Pynckels/versalogic_board_tester/VersaLogic_Board_Tester.pdf

# Data620 Testing Device - Project Overview

The Data620 computer is a unique and fascinating machine built using analog electronic circuitry. It employs a versalogic signaling scheme where a logical false or bit value 0 is represented by 0V, while a logical true or bit value 1 is represented by -12V. This unconventional voltage scheme sets it apart from

many modern digital systems.

Constructed from basic electronic components such as resistors, capacitors,

## diodes, and transistors, the Data620’s entire system is divided into a large

number of printed circuit boards (PCBs). Each PCB contains analog circuitry,

## and it is known that some of these boards may include faulty or erroneous

components.

## Currently, there is no dedicated testing device available to verify the functionality of these PCBs. Such a device would be highly valuable to anyone restoring or working with the Data620, as it would allow for systematic troubleshooting and

repair.

This project represents the first draft towards developing such a testing device.

## It includes preliminary hardware design concepts and the necessary SPICE simulations to understand and verify the circuitry. However, at this stage, only

the hardware draft exists.

## Software development for this testing device is in its early stages and will proceed following the completion of a stable hardware version. It also awaits the reverse

engineering efforts of the DATA620 PCBs carried out by third parties.

This project is currently an independent effort (not affiliated with Usagi Electric or other existing Data620 projects). We hold great respect for the significant contributions and extensive work carried out by Usagi Electric and the dedicated volunteers contributing to the Usagi Electric Data620 project. Our development is separate, however, we are more than willing to explore opportunities to

collaborate and join forces in the future.

As this is an initial draft, the design undoubtedly contains errors and inaccuracies.

## We warmly welcome constructive feedback and suggestions from the community

to improve and refine the project.

## For those interested in learning more about the Data620 itself, the following discussion provides valuable insights and historical context:

## - https://retrocomputingforum.com/t/data-620-transistor-minicomputer/3847 - https://github.com/Nakazoto/Data620 - https://www.youtube.com/watch?v=YR9E9ZvHkQE

## Thank you to all that participate with Usagi Electric for your interest and

support in preserving this remarkable piece of computing history.

1

# License Overview

## Copyright (c) 2011-2025 Filip Pynckels & Robin Pynckels

## This project contains software, hardware designs, and documentation. Each part

is licensed under terms appropriate to its nature. You are free to use, modify, and distribute each component under its respective license terms.

# Hardware Designs

## The schematics, PCB layouts, and other hardware design source files are licensed under the CERN Open Hardware Licence Version 2 - Strongly

Reciprocal (CERN-OHL-S v2.0).

See CERN-OHL-S for the full text.

# Software

## The controller source code, build scripts, and related software files are licensed

under the MIT License.

See MIT for the full text.

# Documentation

## The written documentation, guides, and non-code instructional materials are licensed under the Creative Commons Attribution Non Commercial

Share Alike 4.0 International (CC-NC-SA 4.0) license.

See CC-NC-SA for the full text.

1

# Power Supply UART-RX UART-TX

# FLOATING-SH/~{LD} SIGNAL-OUT-SER

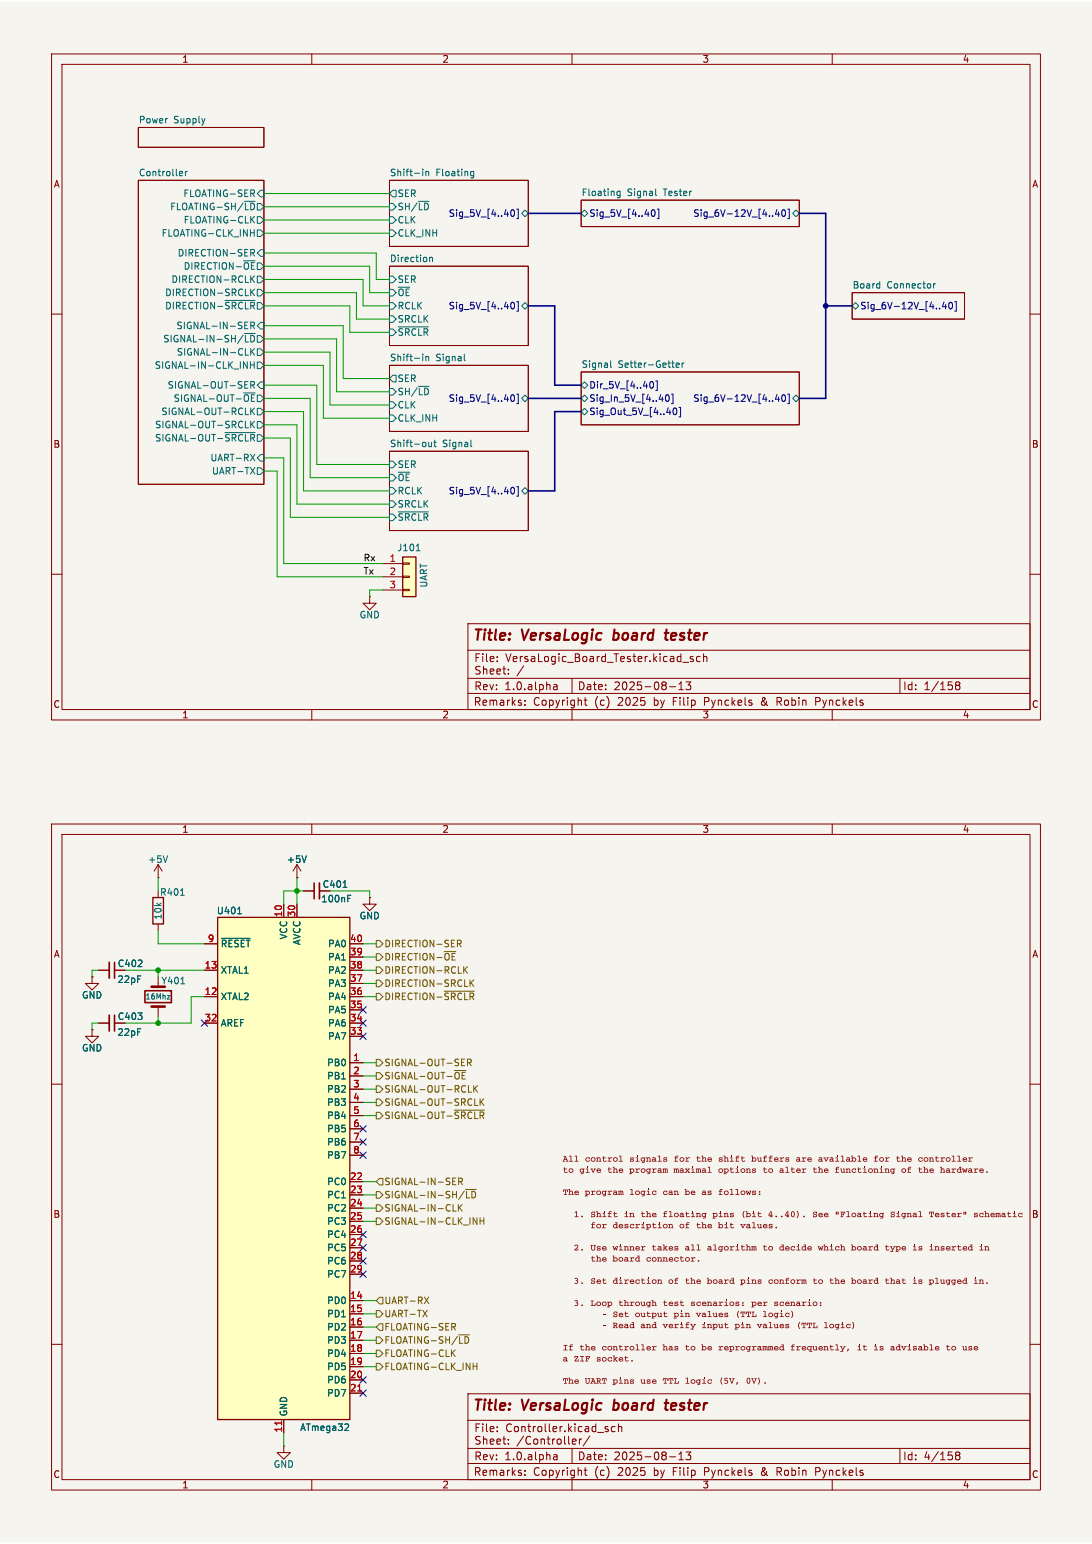
[picture p3: page 3]
BC Date: 2025-08-13 Remarks: Copyright; Filip; Pynckels &; Robin; Pynckels Rev: 1.0.alpha; Id: 1/158 Title: VersaLogic board tester File: VersaLogic_Board_Tester.kicad_sch Sheet: /; FLOATING-SER; DIRECTION-RCLK DIRECTION-~{OE} DIRECTION-SRCLK Controller; Sig_6V-12V_[4..40] Board Connector SER; CLK_INH; CLK; SH/~{LD} Sig_5V_[4..40] Shift-in; Floating; ~{SRCLR} RCLK; ~{OE} SRCLK; SER; Sig_5V_[4..40] Shift-out; Signal CLK_INH; Signal; Sig_5V_[4..40]; Sig_6V-12V_[4..40]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

Sig_5V_[4..40] Direction ~{SRCLR} RCLK

SIGNAL-IN-SH/~{LD} FLOATING-CLK
FLOATING-CLK_INH
SIGNAL-OUT-RCLK DIRECTION-~{SRCLR} DIRECTION-SER

SIGNAL-OUT-~{SRCLR} SIGNAL-IN-SER

SIGNAL-IN-CLK
SIGNAL-IN-CLK_INH

Signal Setter-Getter GND

SIGNAL-OUT-~{OE} SIGNAL-OUT-SRCLK

SIGNAL-IN-CLK DIRECTION-SER
DIRECTION-~{OE} SIGNAL-OUT-SER
SIGNAL-OUT-SRCLK DIRECTION-RCLK DIRECTION-~{SRCLR} FLOATING-CLK_INH
SIGNAL-OUT-~{SRCLR} UART-RX UART-TX

SIGNAL-OUT-~{OE}
SIGNAL-OUT-RCLK

SIGNAL-IN-SER
SIGNAL-IN-SH/~{LD}

FLOATING-SH/~{LD} SIGNAL-IN-CLK_INH

- Set output pin values (TTL logic)

a ZIF socket. The UART pins use TTL logic (5V, 0V).

LM393 +

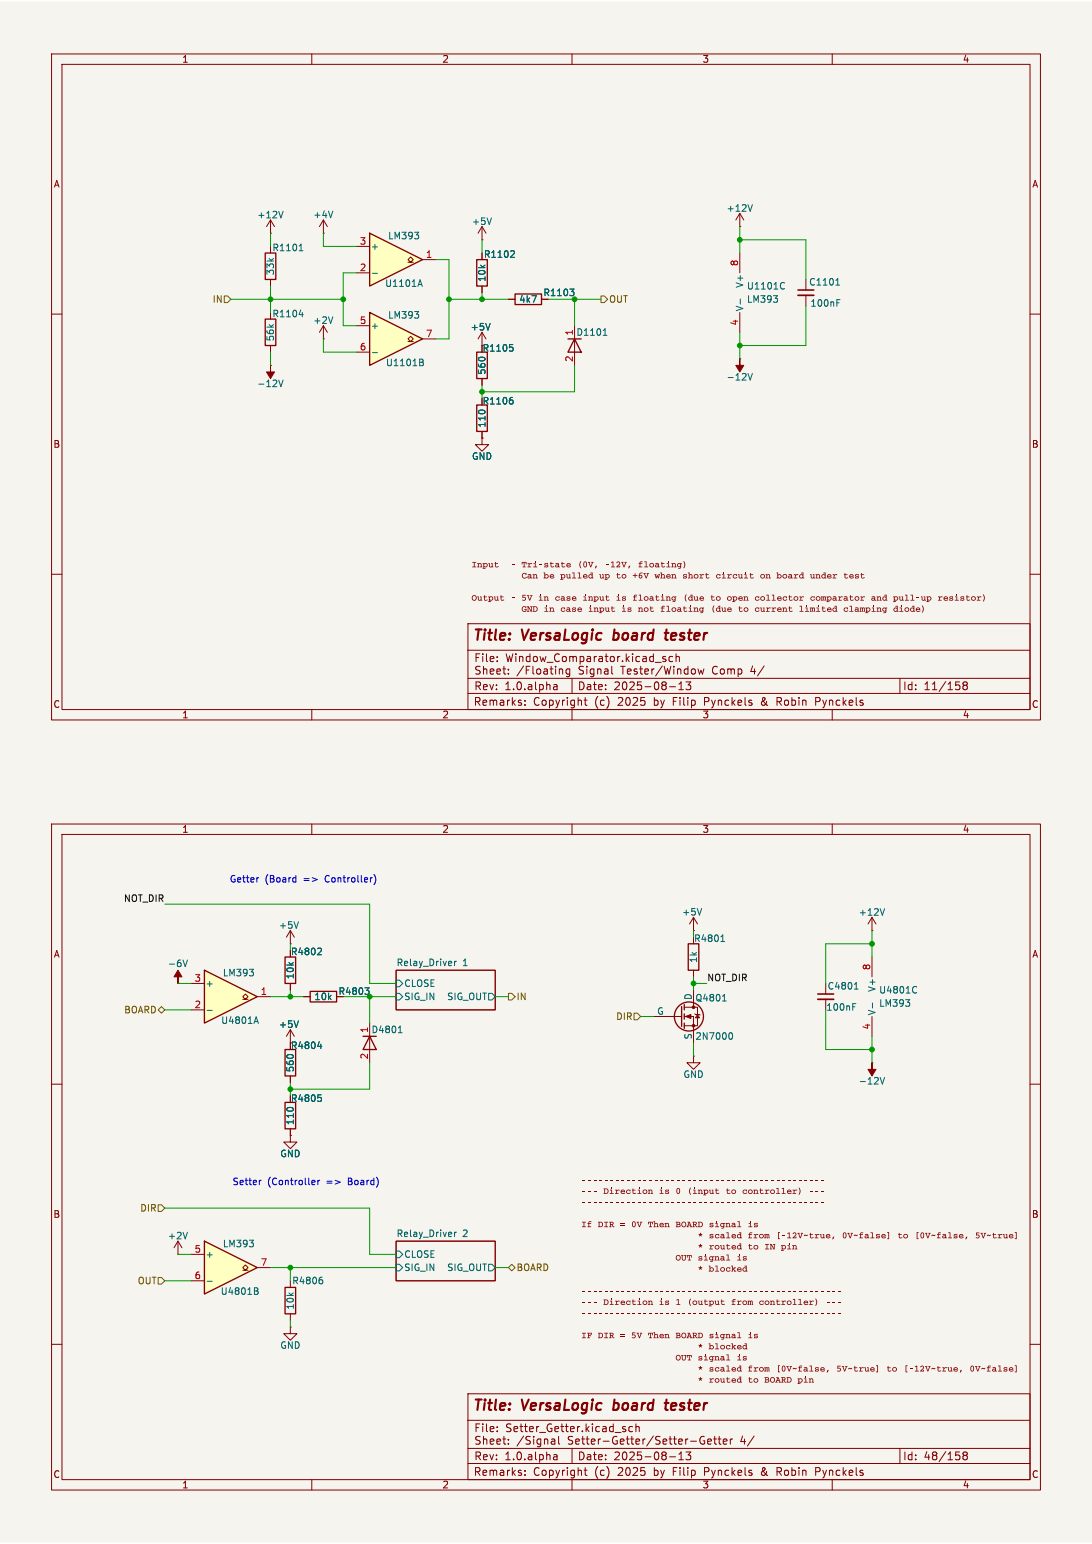
[picture p4: page 4]

If DIR = 0V Then BOARDsignal is

IF DIR = 5V Then BOARDsignal is

* blocked OUT signal is

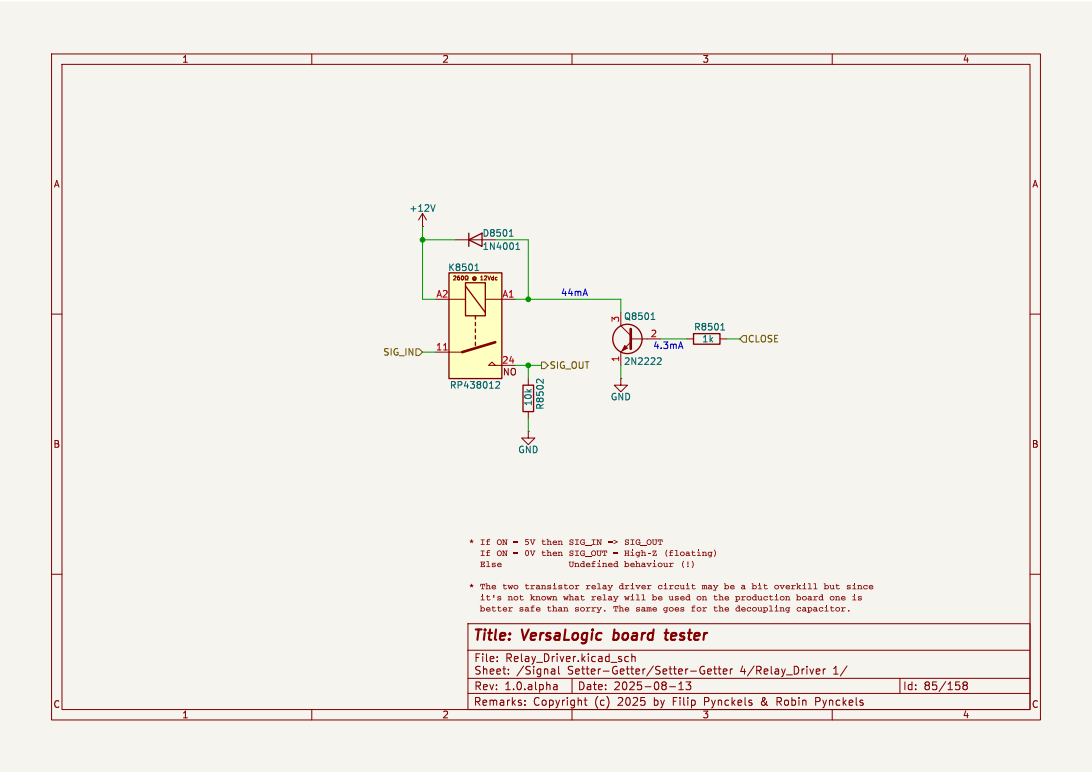
[picture p5: page 5]
BC Date: 2025-08-13 Remarks: Copyright; Filip; Pynckels &; Robin; Pynckels Rev: 1.0.alpha; Id: 85/158 Title: VersaLogic board tester File:; Relay_Driver.kicad_sch Sheet: /Signal; Setter-Getter/Setter-Getter; 4/Relay_Driver; 1/ GND R⁸⁵⁰² ¹⁰k; GND; CLOSE; SIG_OUT SIG_IN; þÿ260©@ 12Vdc NO; If ON = 0V then SIG_OUT = High-Z (floating) Else; Undefined behaviour (!) * The two transistor; relay driver; circuit; may be a bit overkill; but since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

* If ON = 5V then SIG_IN => SIG_OUT

# J301 Connector_Board_Under_Test

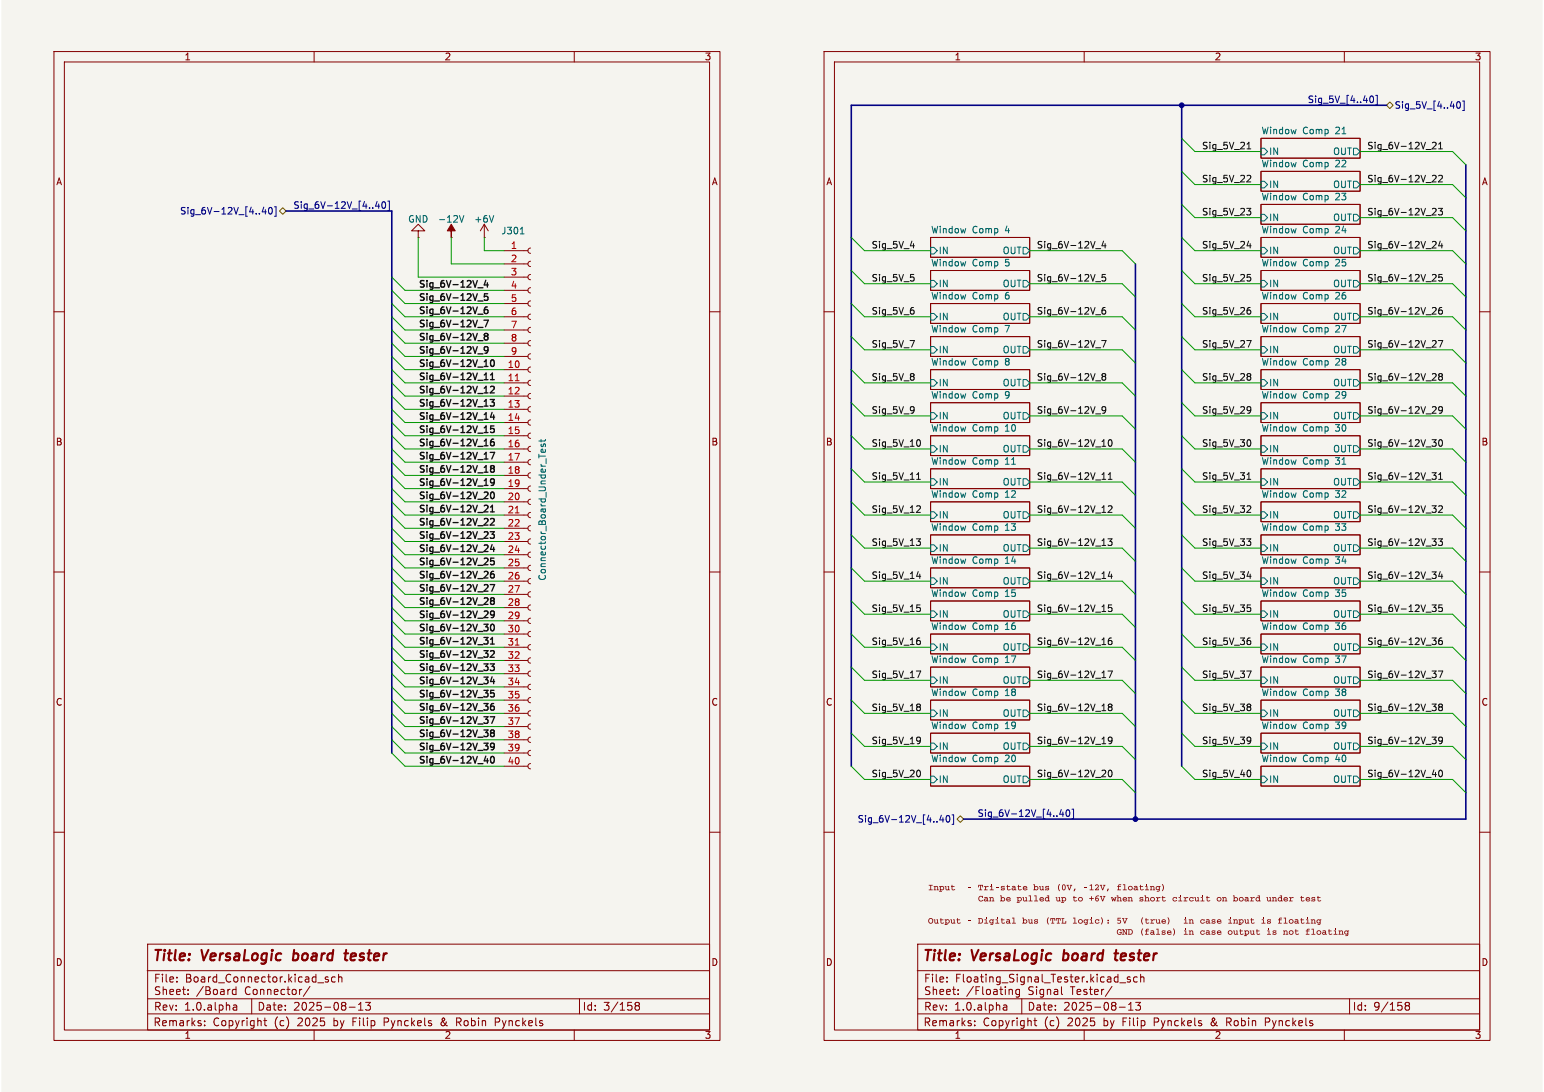
[picture p6: page 6]
D Date: 2025-08-13 Remarks: Copyright; Filip; Pynckels &; Robin; Pynckels Rev: 1.0.alpha; 3/158 Title: VersaLogic board tester File: Board_Connector.kicad_sch Sheet: /Board; Connector/; GND -12V; Sig_6V-12V_[4..40]; Sig_6V-12V_15; Sig_6V-12V_23; Sig_6V-12V_22; Sig_6V-12V_24; Sig_6V-12V_6; Sig_6V-12V_5; Sig_6V-12V_18; Sig_6V-12V_17; Sig_6V-12V_19 Sig_6V-12V_20; Sig_6V-12V_4; Sig_6V-12V_16; Sig_6V-12V_40; Sig_6V-12V_39; Sig_6V-12V_38; Sig_6V-12V_33; Sig_6V-12V_32; Sig_6V-12V_31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

+5V C213

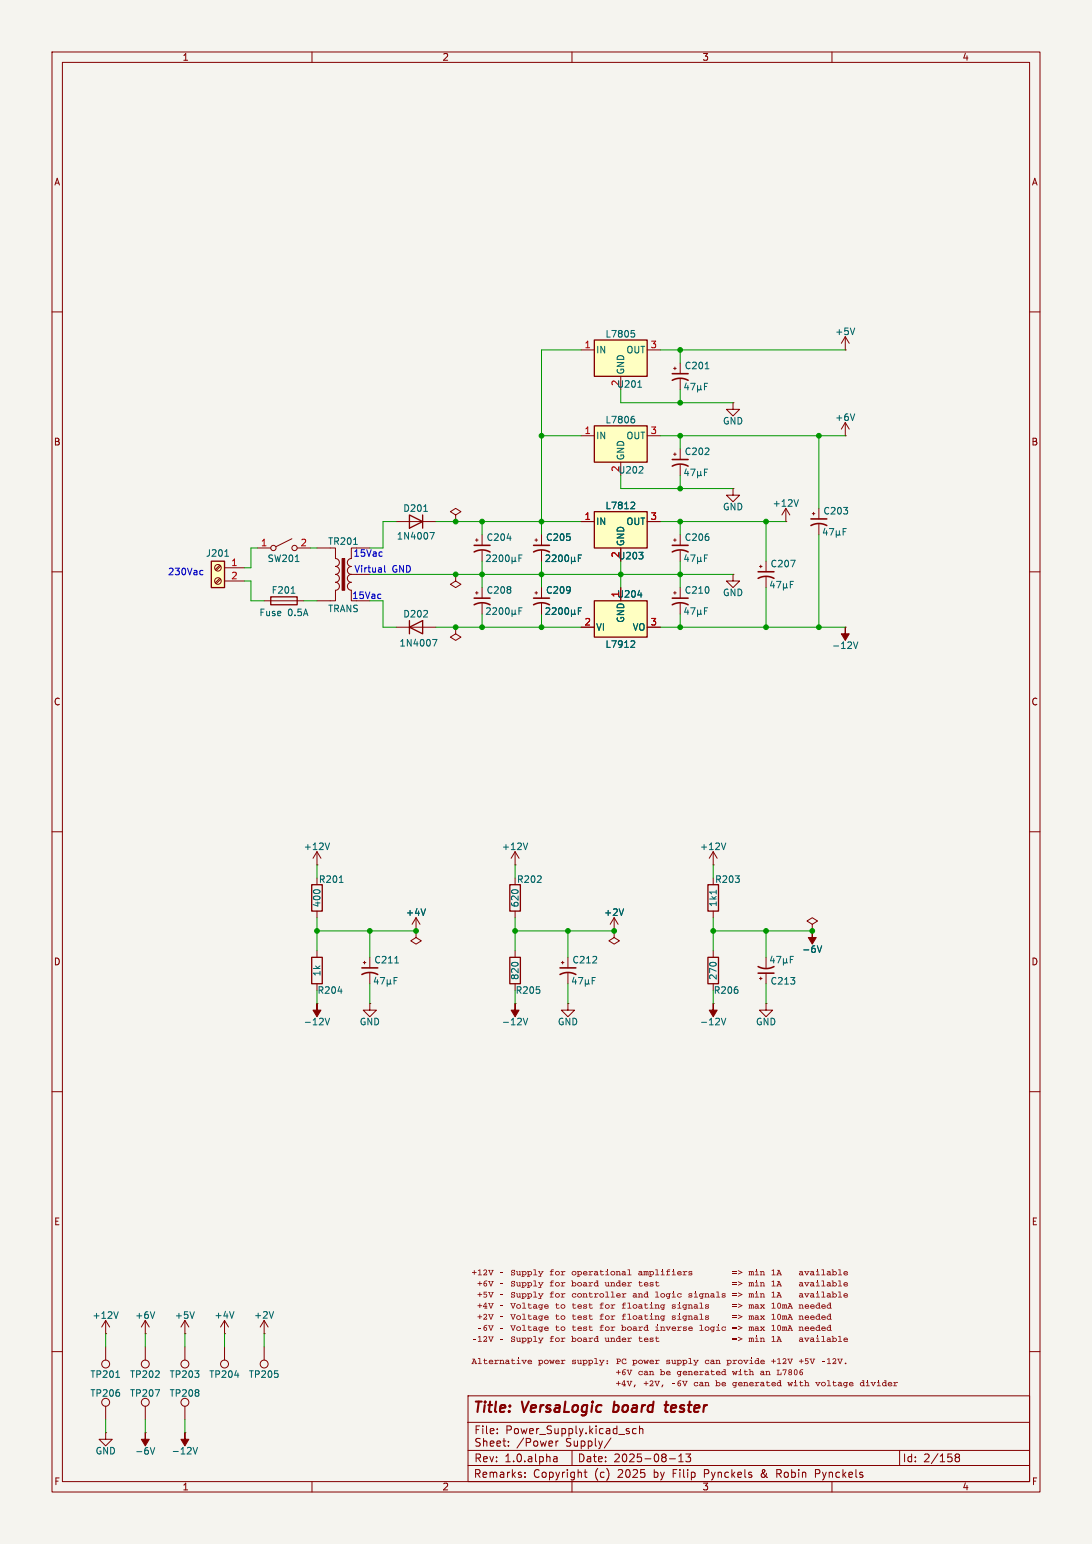
[picture p7: page 7]

-6V - Voltage to test for board inverse logic => max 10mA needed

# +5V GND

# SH/~{LD} 1 CLK 2 SER 10 CLK_INH 15 ~{QH} 7 QH 9 VCC ¹⁶ GND

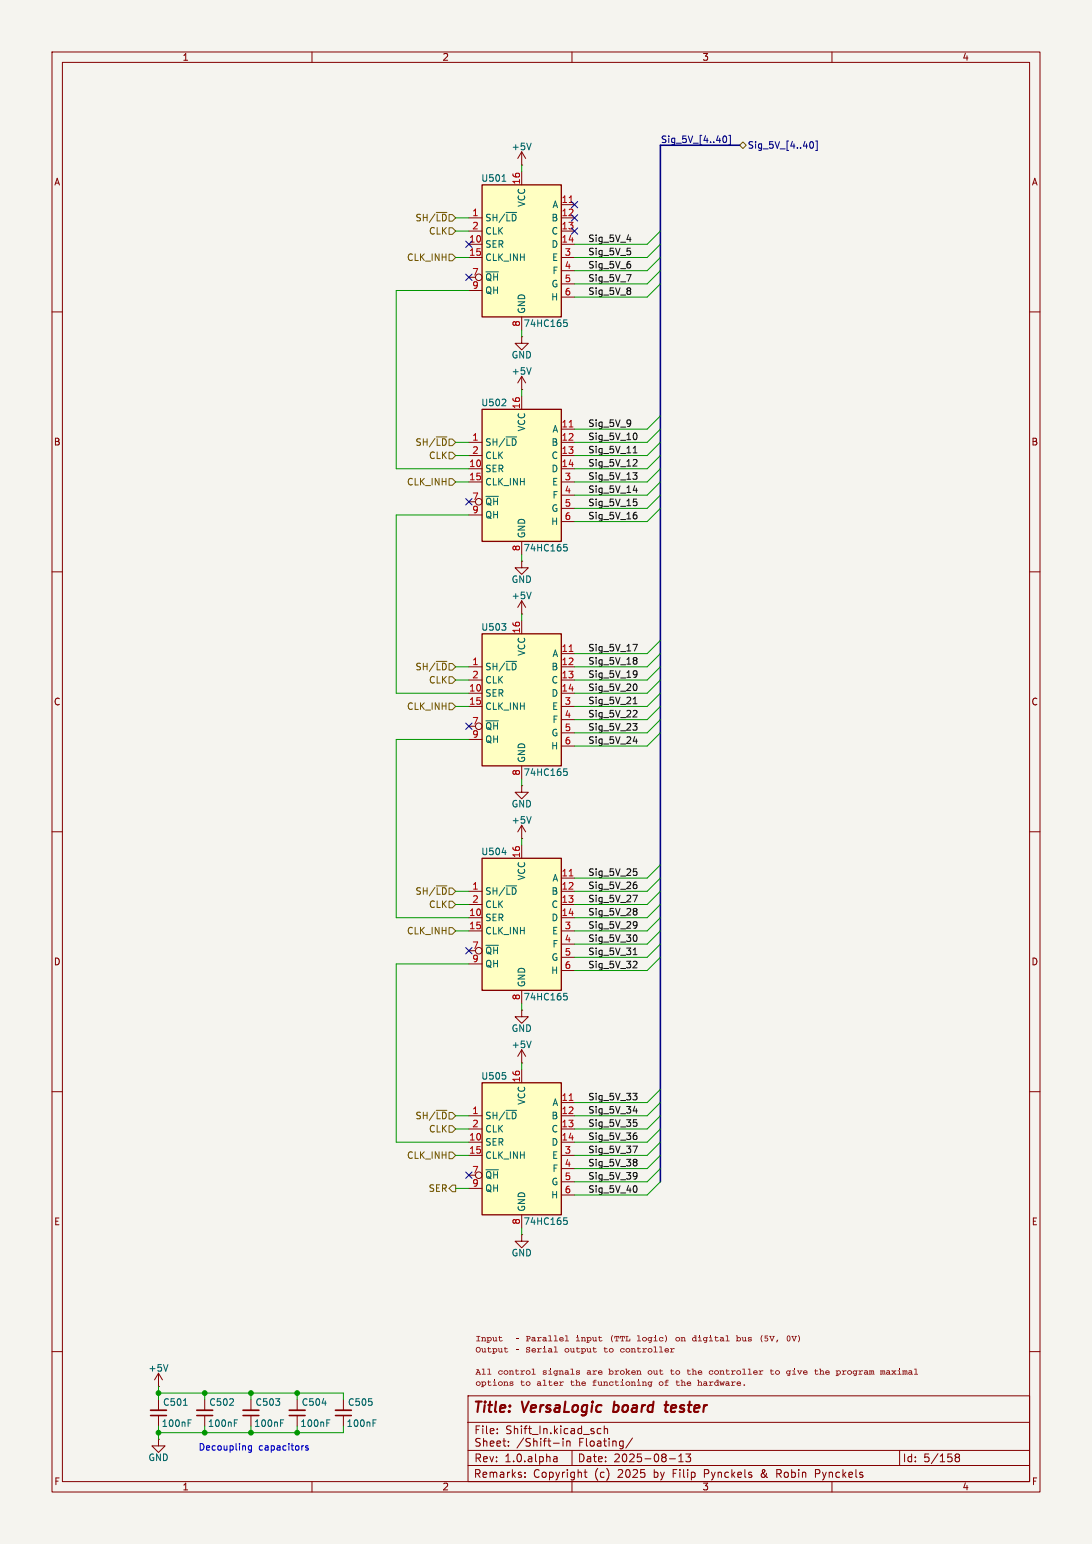
[picture p8: page 8]

# +5V GND

# SH/~{LD} 1 CLK 2 SER 10 CLK_INH 15 ~{QH} 7 QH 9 VCC ¹⁶ GND

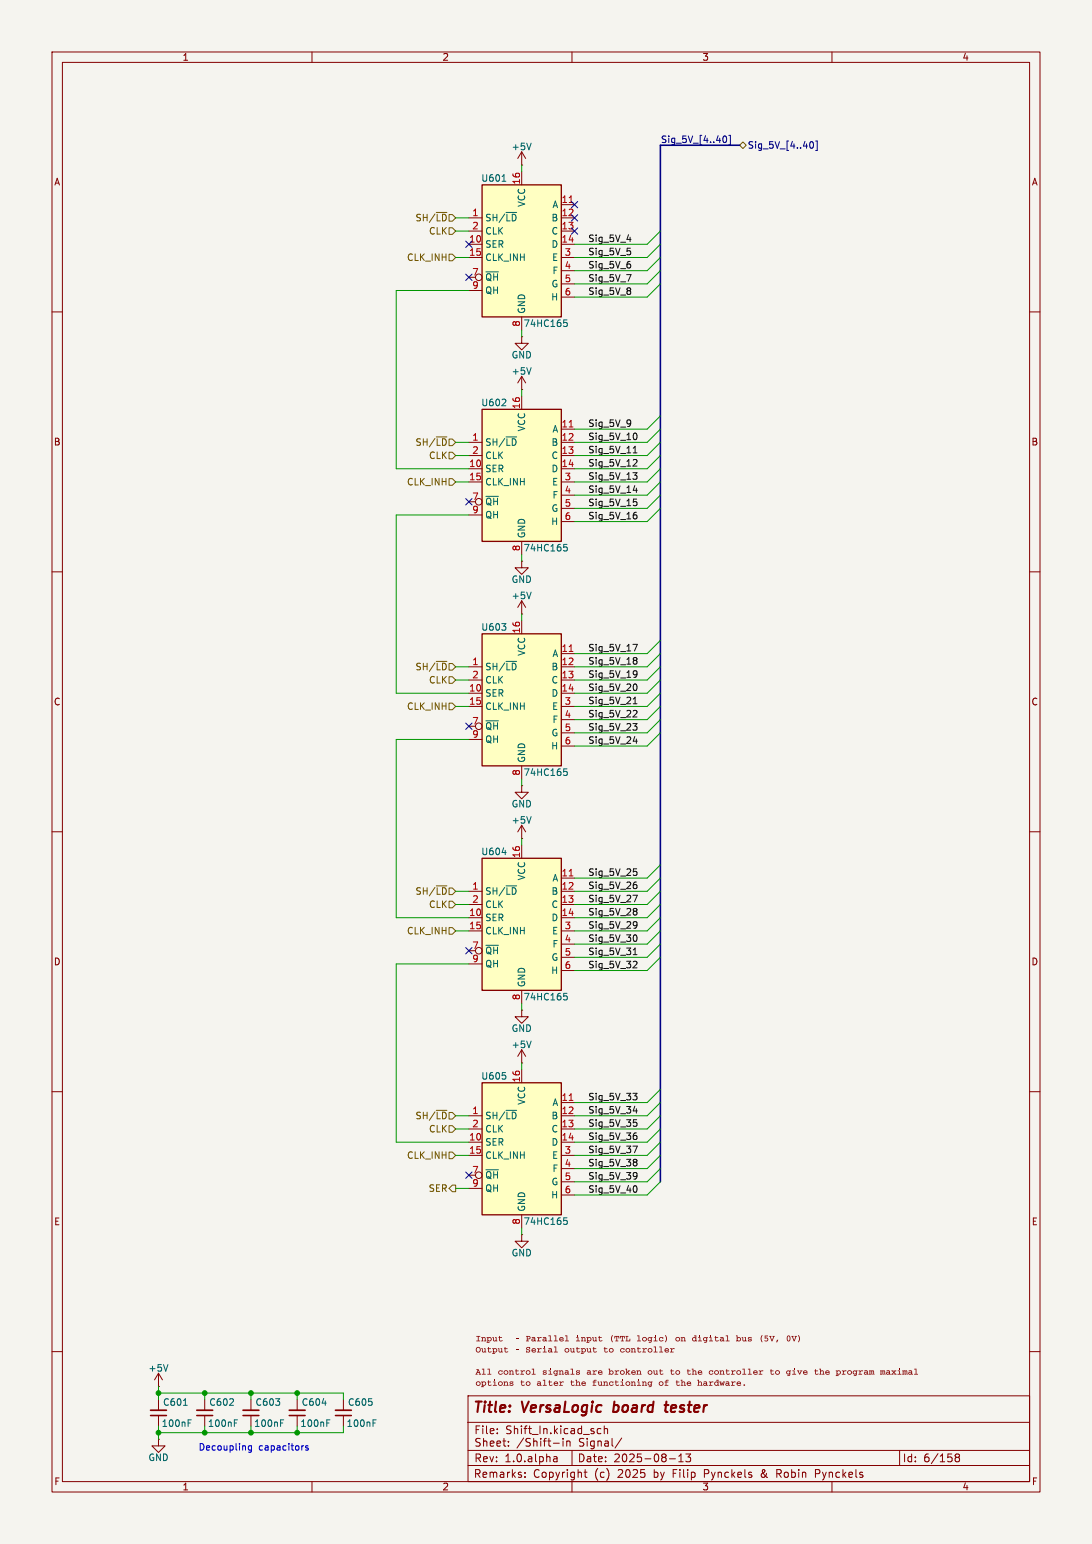
[picture p9: page 9]

SER 14 ~{OE} 13 RCLK 12 SRCLK 11 ~{SRCLR} 10 ~{QH} 9 | VCC ¹⁶ GND
74HC595 SER 14 ~{OE} 13 RCLK 12 SRCLK 11 ~{SRCLR} 10 ~{QH} 9 | VCC ¹⁶ GND

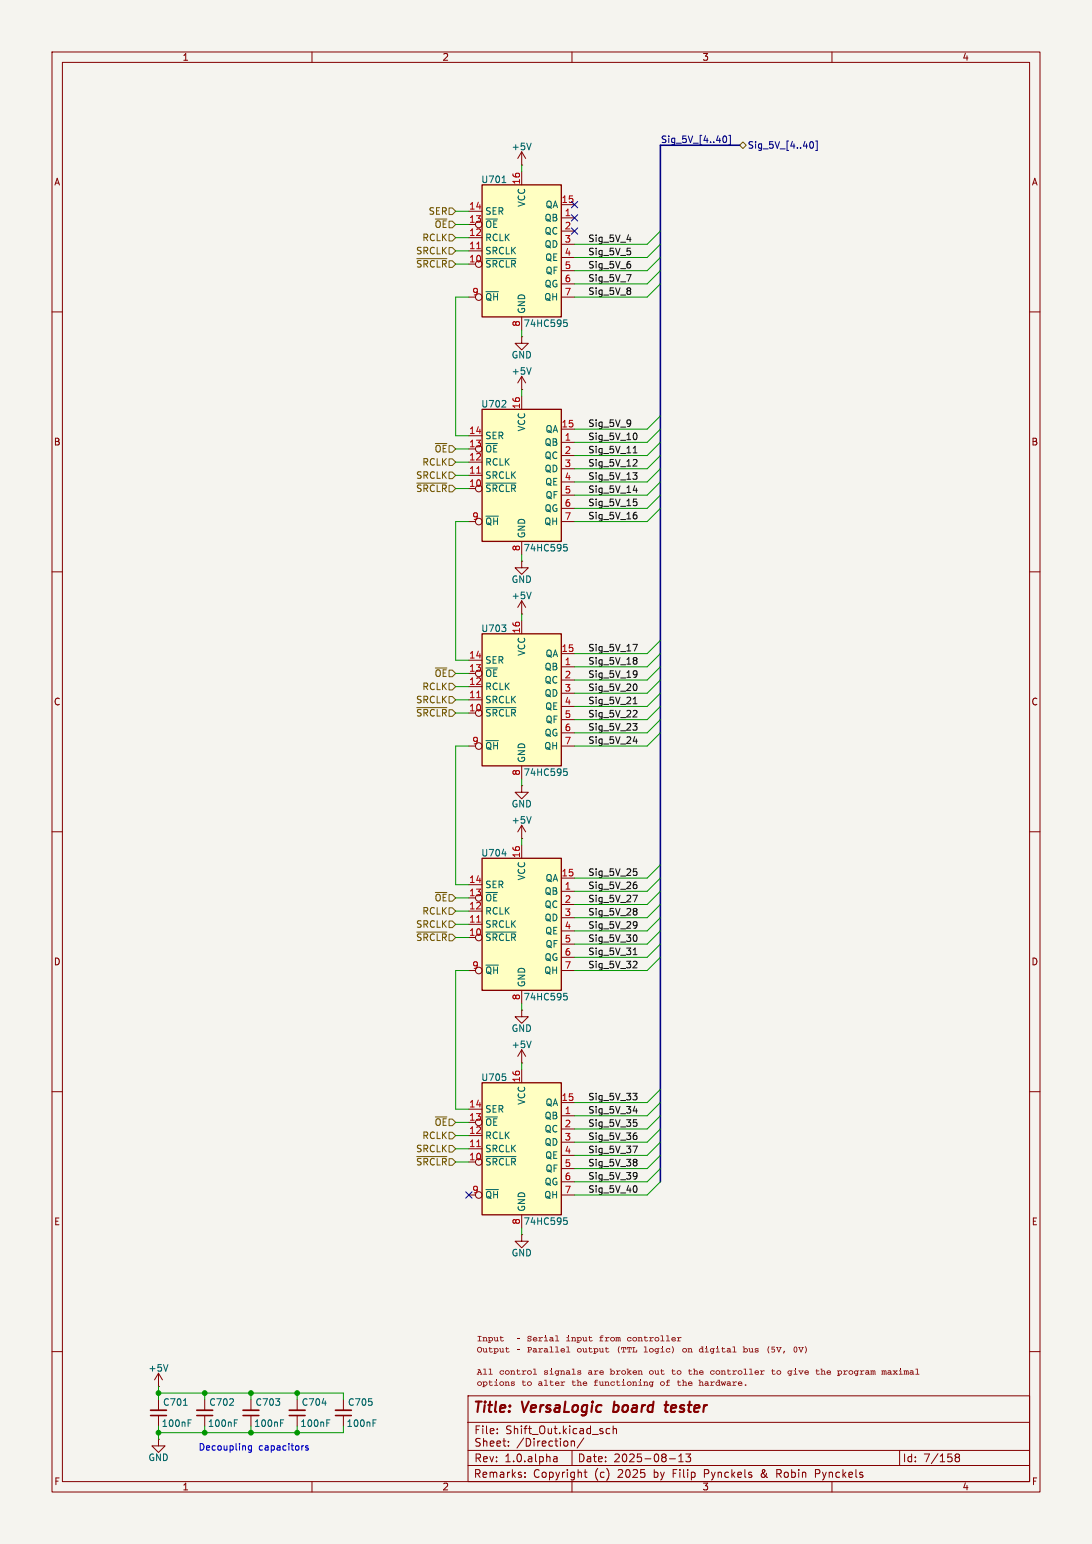
[picture p10: page 10]

~{OE} RCLK
SRCLK

SER 14 ~{OE} 13 RCLK 12 SRCLK 11 ~{SRCLR} 10 ~{QH} 9 | VCC ¹⁶ GND
74HC595 SER 14 ~{OE} 13 RCLK 12 SRCLK 11 ~{SRCLR} 10 ~{QH} 9 | VCC ¹⁶ GND

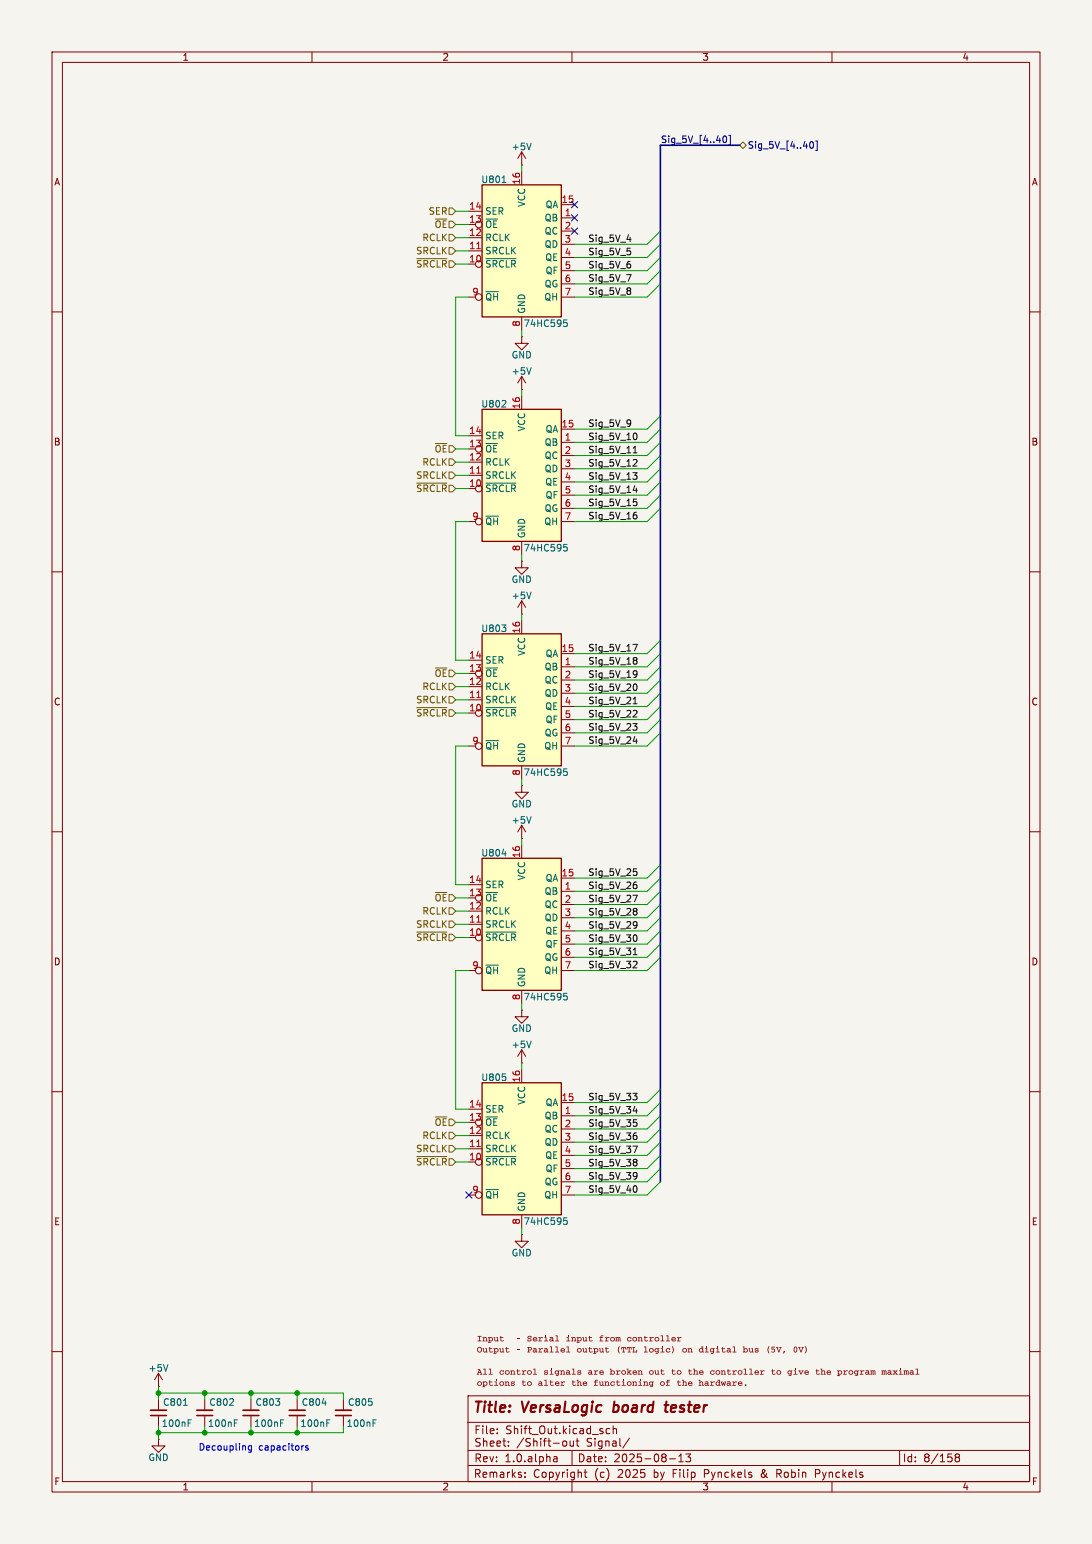
[picture p11: page 11]

~{OE} RCLK
SRCLK

# Sig_In_5V_9 Dir_5V_6 Sig_Out_5V_5 Dir_5V_4 Sig_Out_5V_7

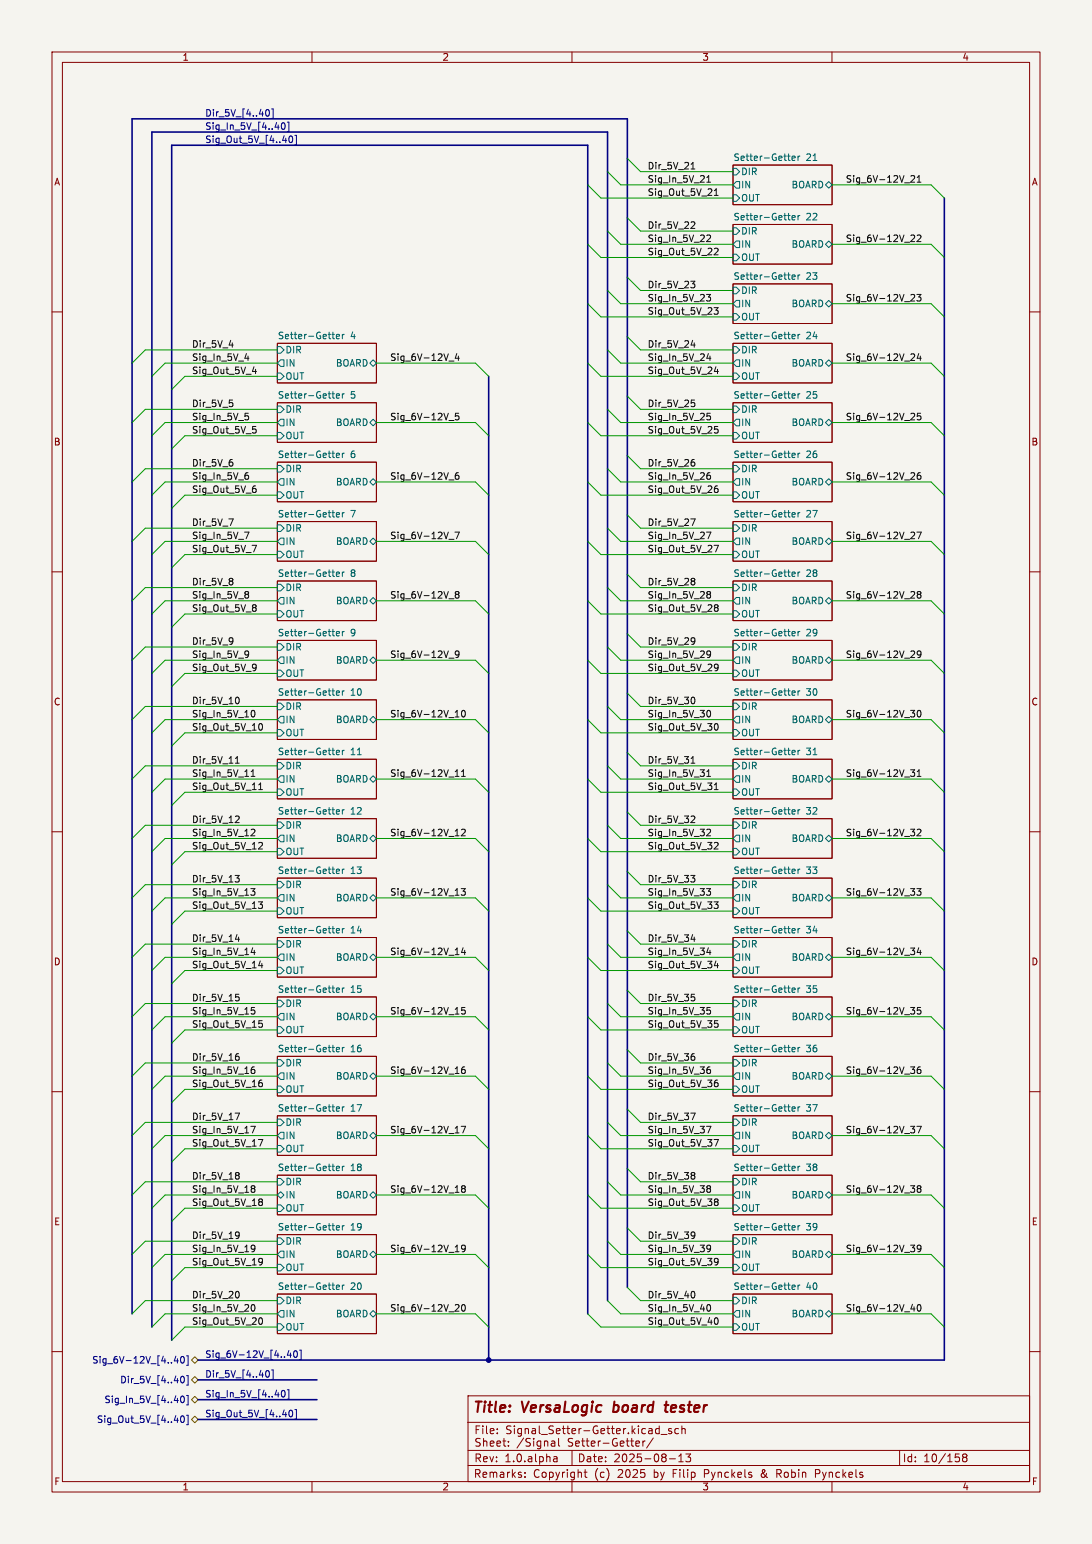
[picture p12: page 12]
F Date: 2025-08-13 Remarks: Copyright; Filip; Pynckels &; Robin; Pynckels Rev: 1.0.alpha; Id: 10/158 Title: VersaLogic board tester File: Signal_Setter-Getter.kicad_sch Sheet: /Signal; Setter-Getter/; BOARD; DIR OUT Setter-Getter; Sig_In_5V_[4..40]; Sig_6V-12V_[4..40]; Dir_5V_[4..40]; Sig_Out_5V_[4..40]; Dir_5V_40 Sig_In_5V_39; Sig_Out_5V_39; Sig_Out_5V_33 Dir_5V_33; Dir_5V_23; Sig_In_5V_38; Sig_In_5V_33 Dir_5V_39 Sig_Out_5V_38; Sig_In_5V_37; Sig_Out_5V_31; Sig_In_5V_32; Sig_6V-12V_32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
