Pynckels/versalogic_board_tester/hardware/proofs_of_concept/Cascaded_74xx165/result/Cascaded_74xx165_output.png

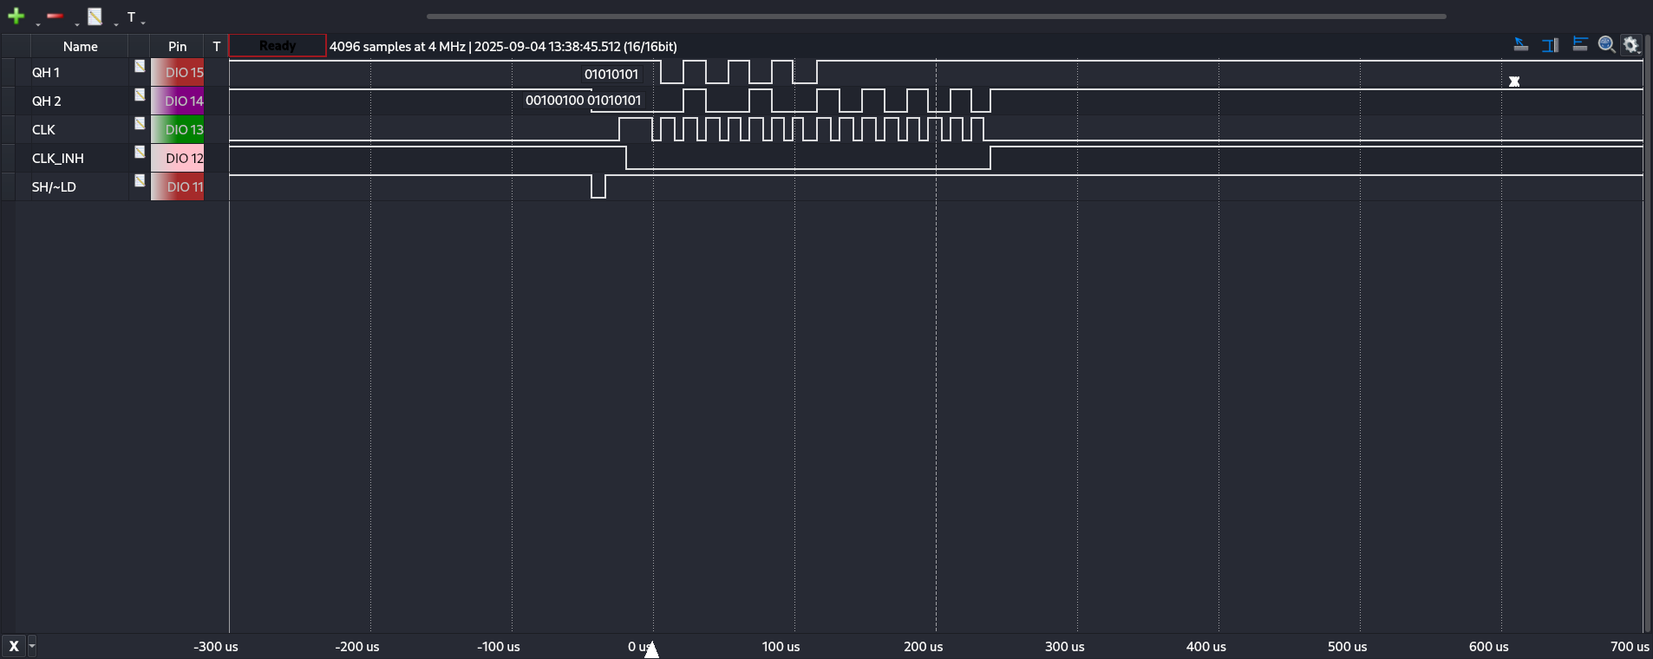
hardware/proofs_of_concept/Cascaded_74xx165/result/Cascaded_74xx165_output.png
