Pynckels/versalogic_board_tester/hardware/proofs_of_concept/Cascaded_74xx595/result/Cascaded_74xx595_breadboard.png

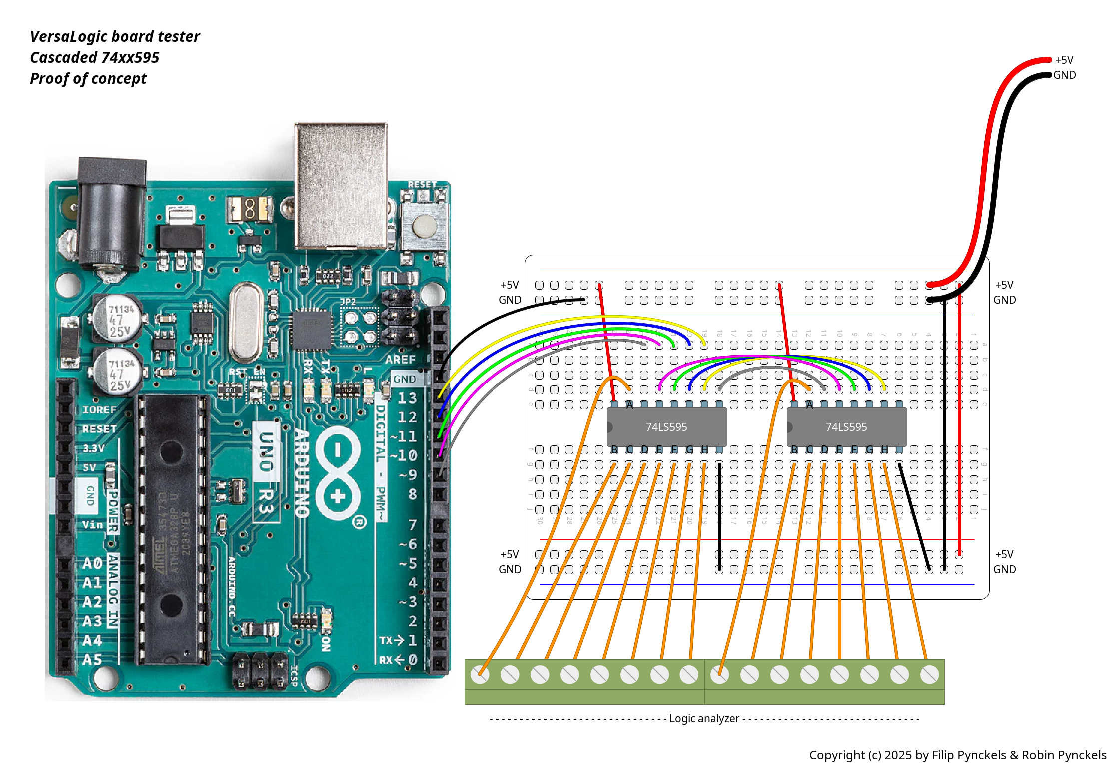
hardware/proofs_of_concept/Cascaded_74xx595/result/Cascaded_74xx595_breadboard.png
