Pynckels/versalogic_board_tester/hardware/proofs_of_concept/Cascaded_74xx595/result/Cascaded_74xx595_photo.jpg

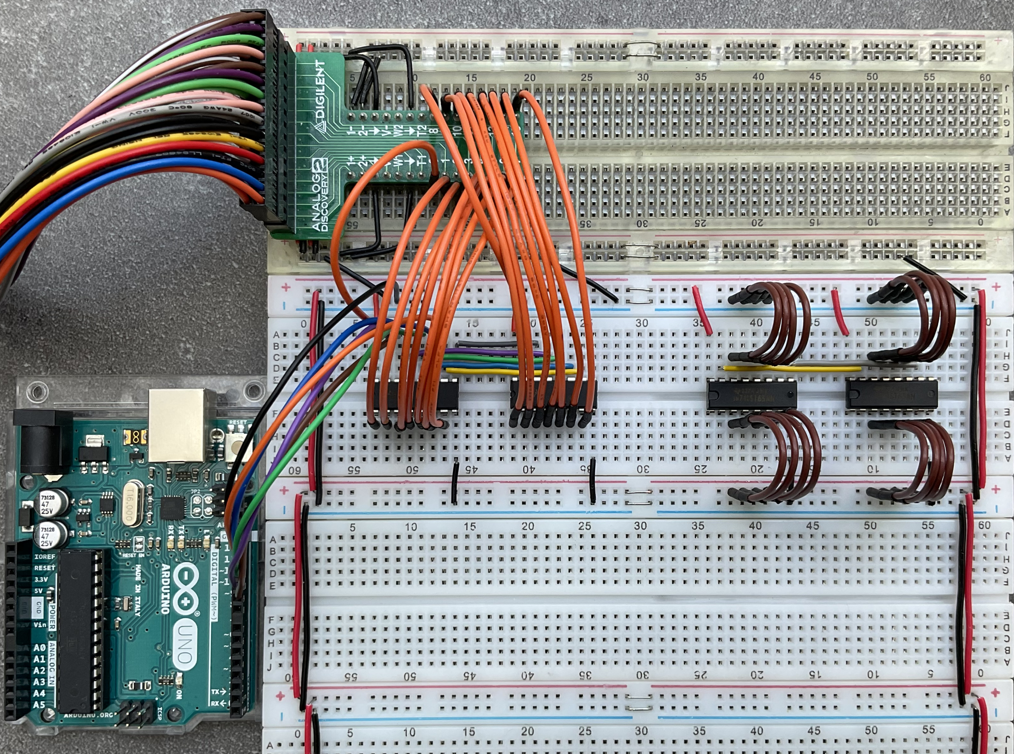
hardware/proofs_of_concept/Cascaded_74xx595/result/Cascaded_74xx595_photo.jpg
