Pynckels/versalogic_board_tester/hardware/proofs_of_concept/Relay_Driver/result/Relay_Driver_output.png

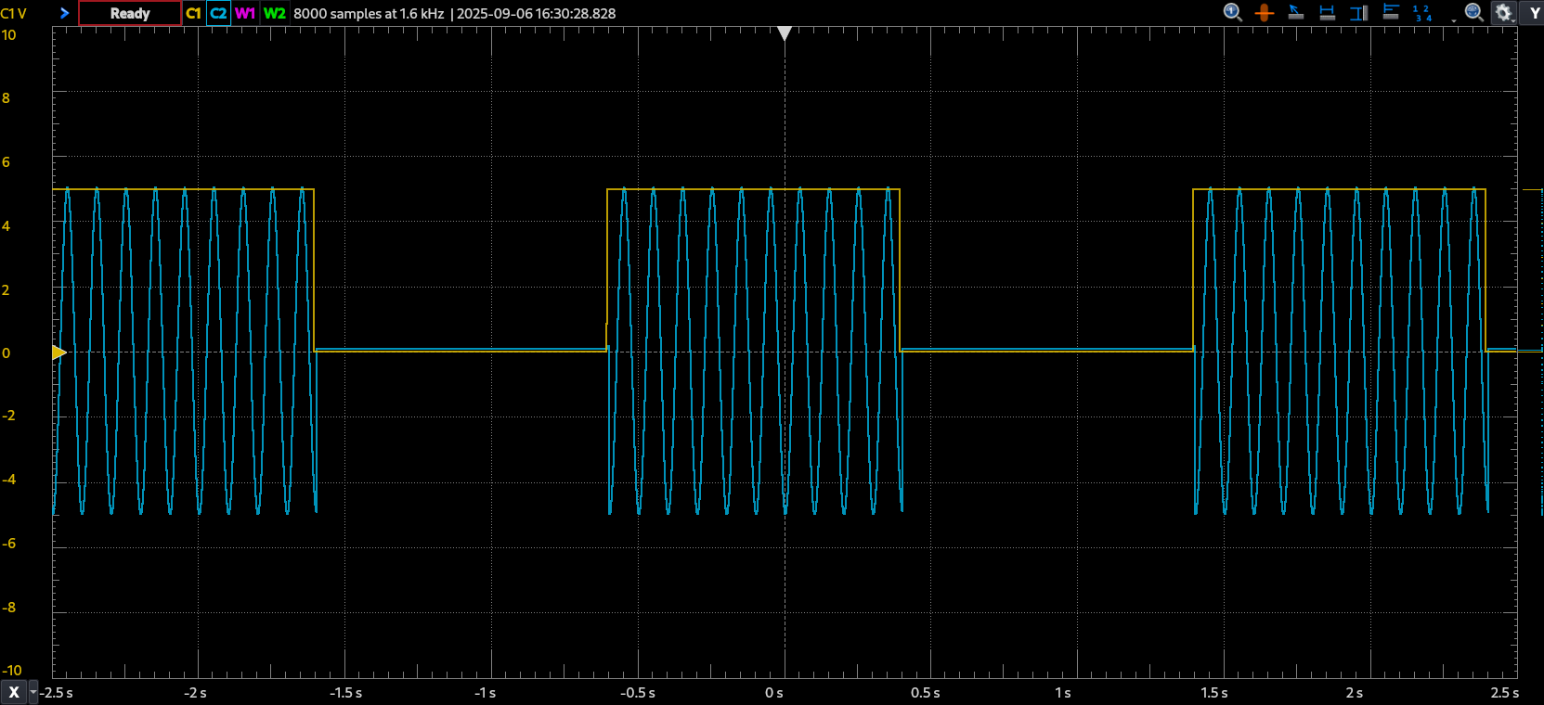
hardware/proofs_of_concept/Relay_Driver/result/Relay_Driver_output.png
