Pynckels/versalogic_board_tester/hardware/proofs_of_concept/Window_Comparator/result/Window_Comparator_photo.jpg

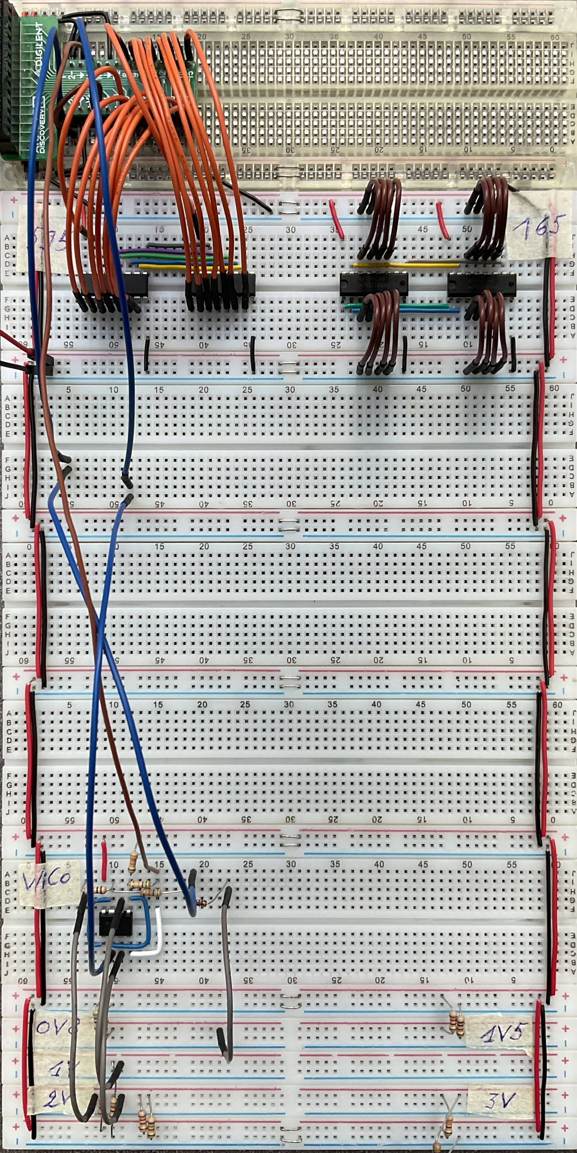
hardware/proofs_of_concept/Window_Comparator/result/Window_Comparator_photo.jpg
