Pynckels/versalogic_board_tester/hardware/simulations/Cascaded_74xx165/result/tb_cascaded_74xx165.png

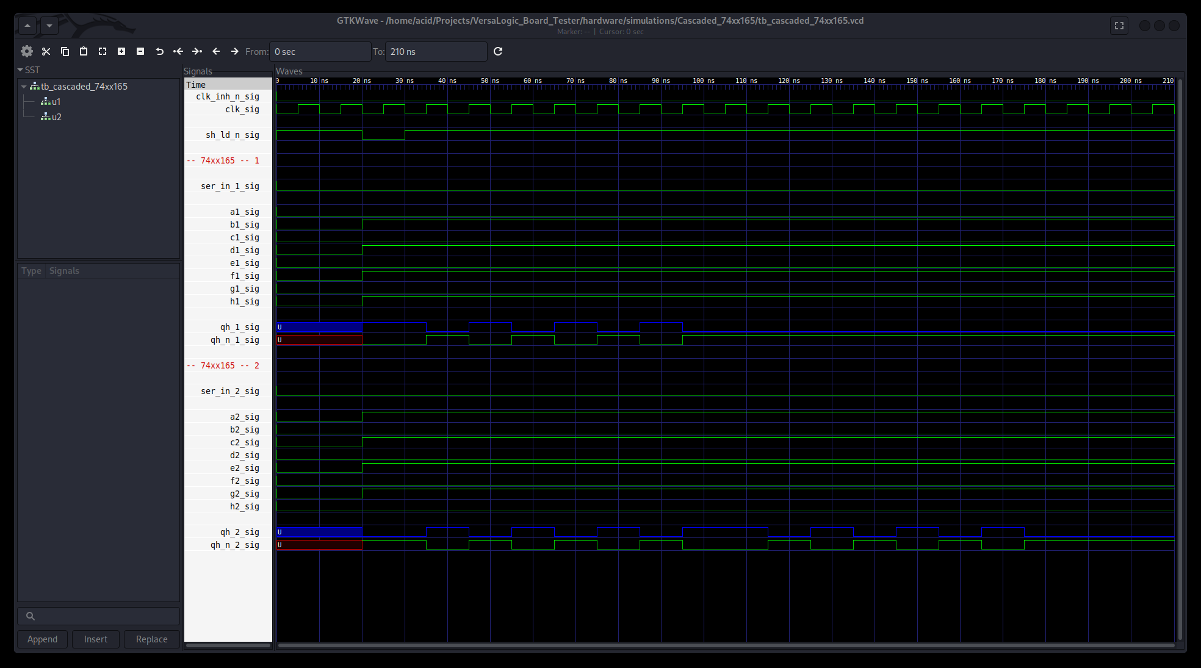
hardware/simulations/Cascaded_74xx165/result/tb_cascaded_74xx165.png
