Pynckels/versalogic_board_tester/hardware/simulations/Cascaded_74xx595/result/tb_cascaded_74xx595.png

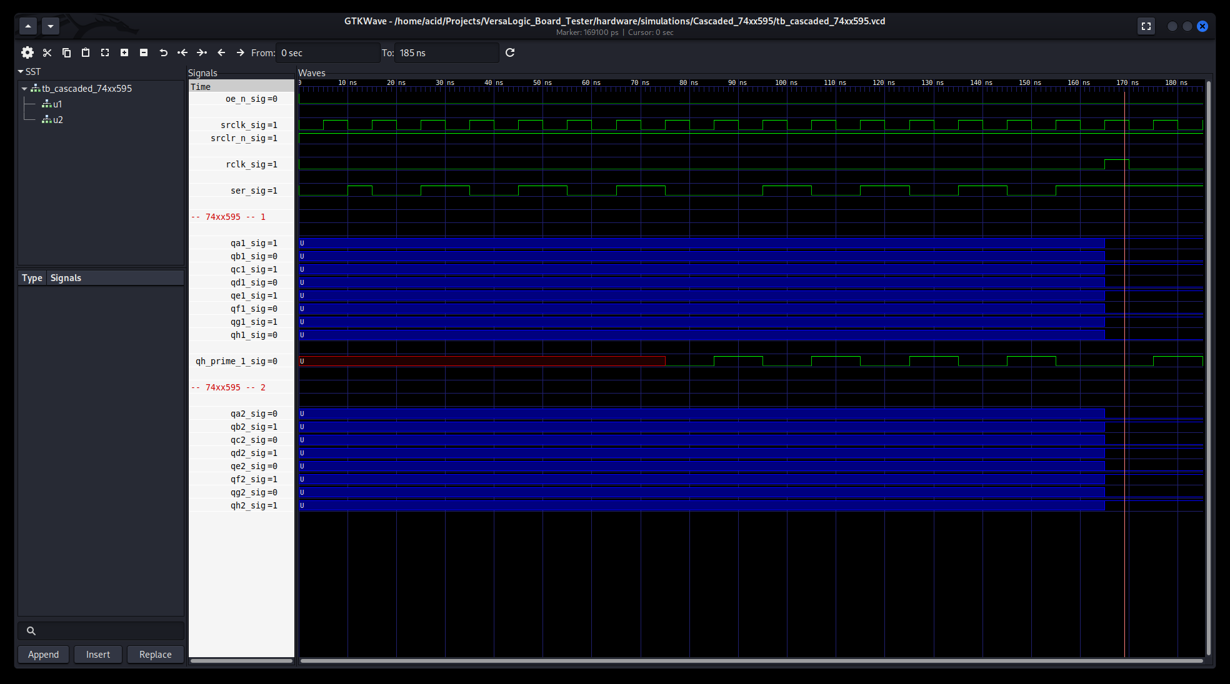
hardware/simulations/Cascaded_74xx595/result/tb_cascaded_74xx595.png
