Pynckels/versalogic_board_tester/hardware/simulations/Setter_Getter/result/Setter_Getter_Board-to-Controller.png

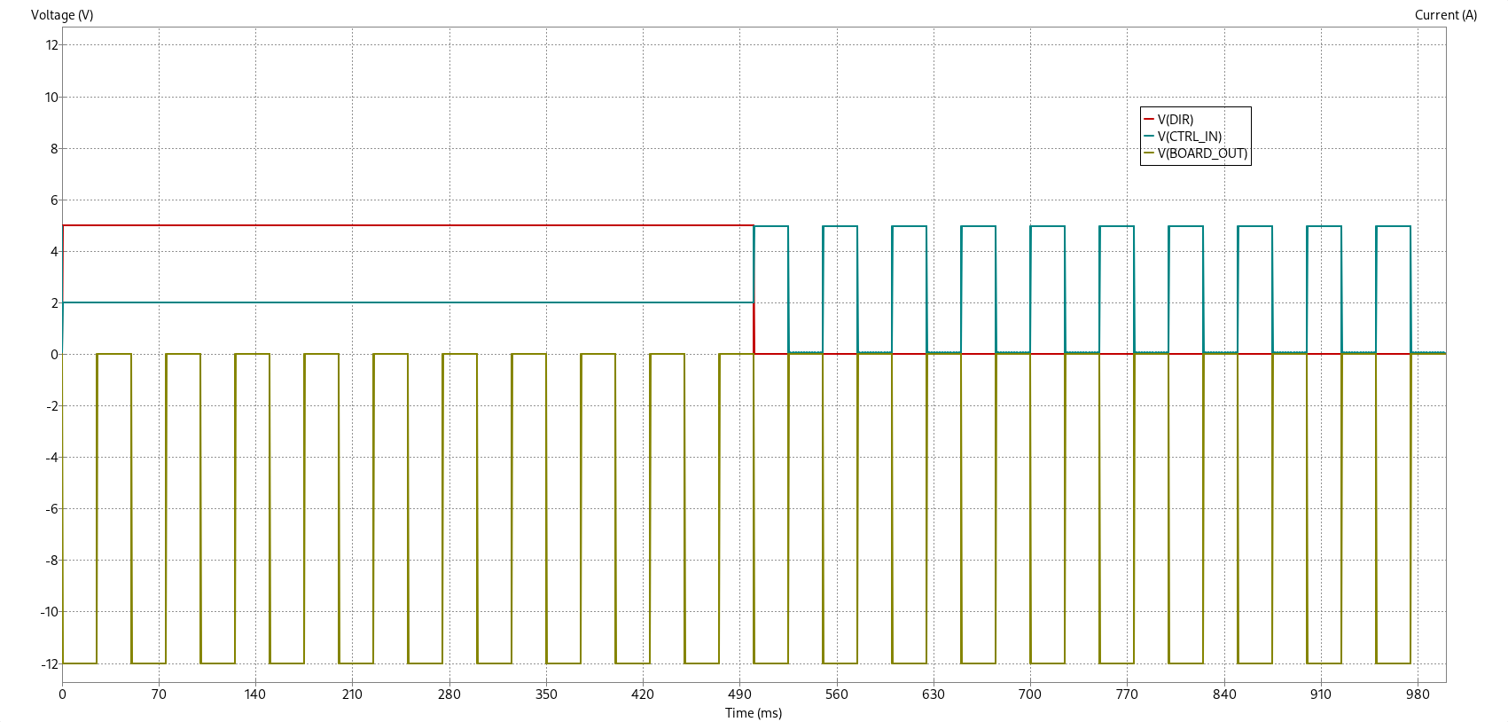
hardware/simulations/Setter_Getter/result/Setter_Getter_Board-to-Controller.png
