Pynckels/versalogic_board_tester/hardware/simulations/Setter_Getter/result/Setter_Getter_Controller-to-Board.png

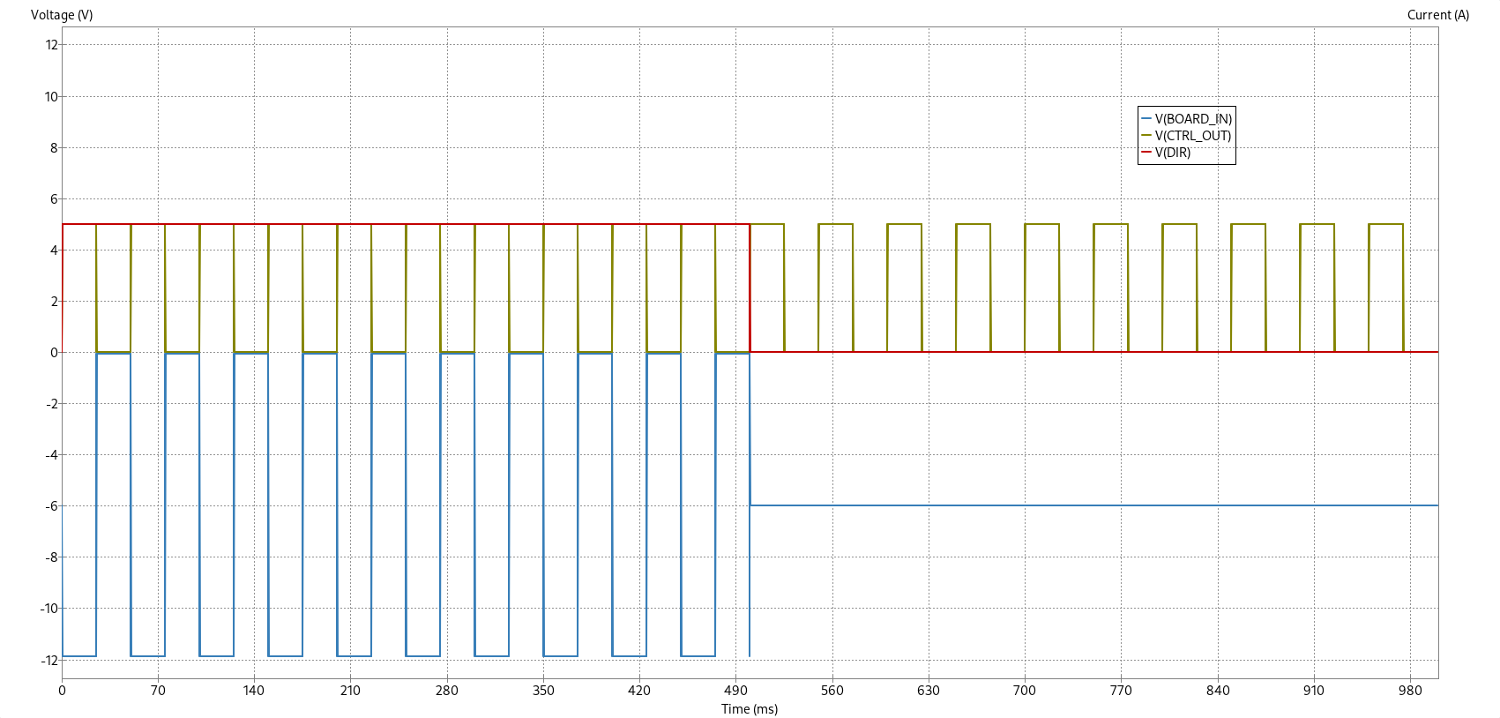
hardware/simulations/Setter_Getter/result/Setter_Getter_Controller-to-Board.png
