Pynckels/versalogic_board_tester/hardware/simulations/Window_Comparator/result/Window_Comparator.png

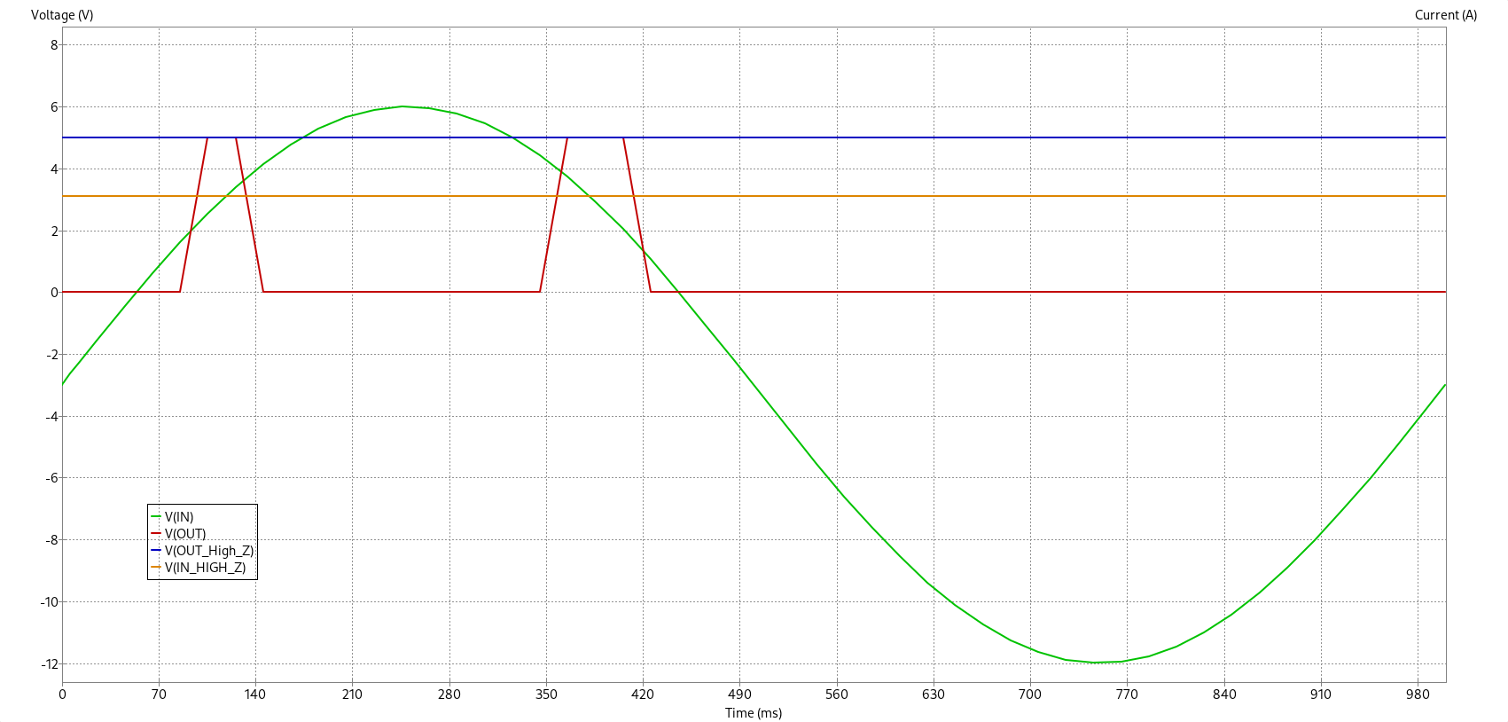
hardware/simulations/Window_Comparator/result/Window_Comparator.png
