Pynckels/versalogic_board_tester/hardware/design/Controller.kicad_sch

## KiCad design hardware/design/Controller.kicad_sch (2025-08-26)

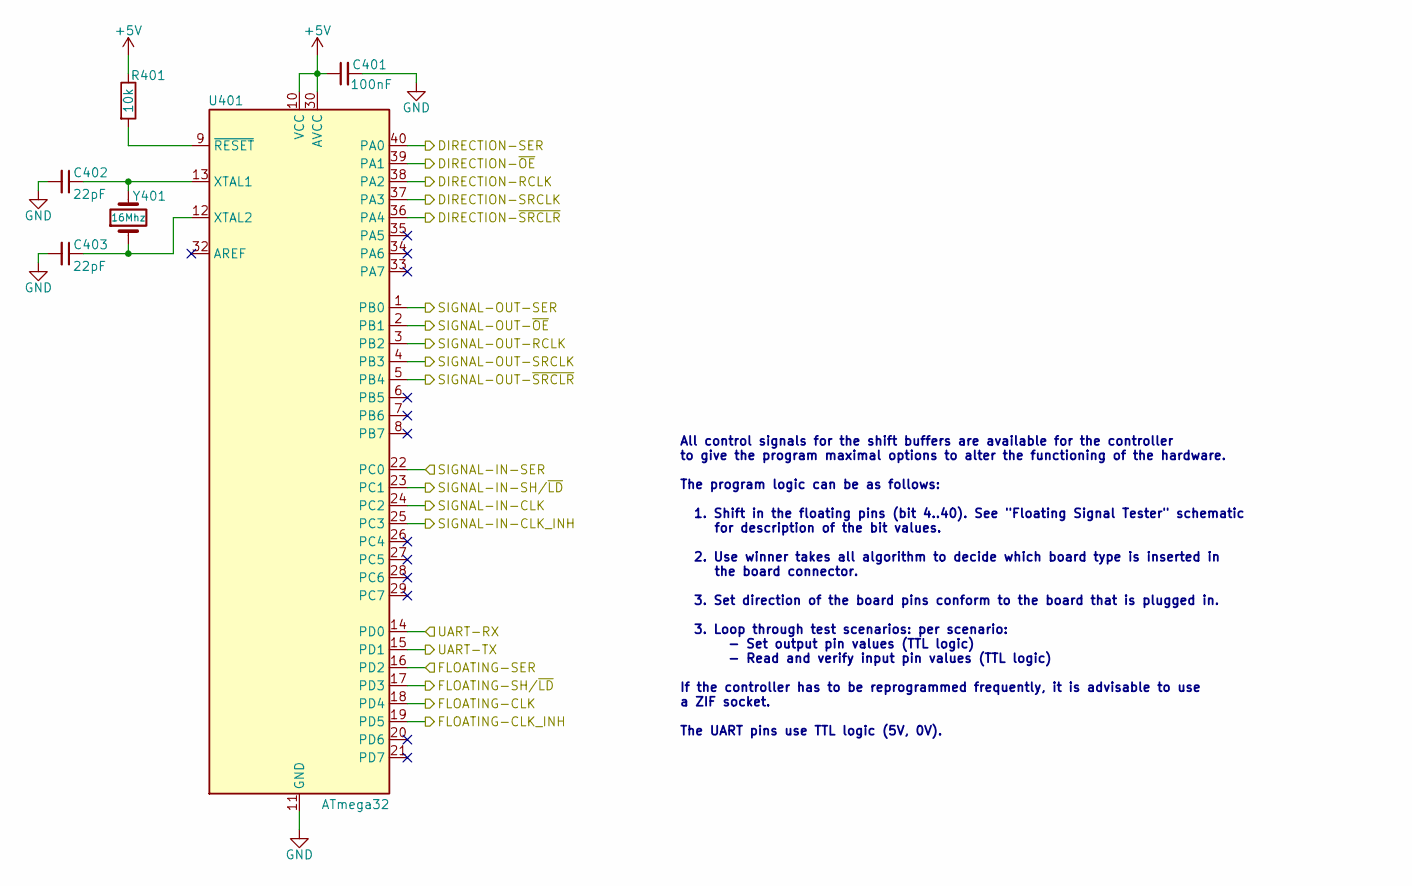
[picture p27: schematic Controller.kicad_sch]

Parts:
C401: 100nF; C_Disc_D5.0mm_W2.5mm_P5.00mm
C402, C403: 22pF; C_Disc_D3.0mm_W1.6mm_P2.50mm
R401: 10k; R_Axial_DIN0207_L6.3mm_D2.5mm_P7.62mm_Horizontal
U401: ATmega32; DIP-40_W15.24mm
Y401: 16Mhz; Crystal_HC49-U_Vertical

Connections:
+5V: C401.1, R401.1, U401.10 (VCC), U401.30 (AVCC)
DIRECTION-RCLK: U401.38 (PA2)
DIRECTION-SER: U401.40 (PA0)
DIRECTION-SRCLK: U401.37 (PA3)
DIRECTION-~OE: U401.39 (PA1)
DIRECTION-~SRCLR: U401.36 (PA4)
FLOATING-CLK: U401.18 (PD4)
FLOATING-CLK_INH: U401.19 (PD5)
FLOATING-SER: U401.16 (PD2)
FLOATING-SH/~LD: U401.17 (PD3)
GND: C401.2, C402.2, C403.2, U401.11 (GND), U401.31 (GND)
unnamed: C402.1, U401.13 (XTAL1), Y401.2
unnamed: C403.1, U401.12 (XTAL2), Y401.1
unnamed: R401.2, U401.9 (~RESET)
SIGNAL-IN-CLK: U401.24 (PC2)
SIGNAL-IN-CLK_INH: U401.25 (PC3)
SIGNAL-IN-SER: U401.22 (PC0)
SIGNAL-IN-SH/~LD: U401.23 (PC1)
SIGNAL-OUT-RCLK: U401.3 (PB2)
SIGNAL-OUT-SER: U401.1 (PB0)
SIGNAL-OUT-SRCLK: U401.4 (PB3)
SIGNAL-OUT-~OE: U401.2 (PB1)
SIGNAL-OUT-~SRCLR: U401.5 (PB4)
UART-RX: U401.14 (PD0)
UART-TX: U401.15 (PD1)

Notes on the sheet:
All control signals for the shift buffers are available for the controller to give the program maximal options to alter the functioning of the hardware. The program logic can be as follows: 1. Shift in the floating pins (bit 4..40). See "Floating Signal Tester" schematic for description of the bit 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
