Pynckels/versalogic_board_tester/hardware/design/Power_Supply.kicad_sch

## KiCad design hardware/design/Power_Supply.kicad_sch (2025-08-26)

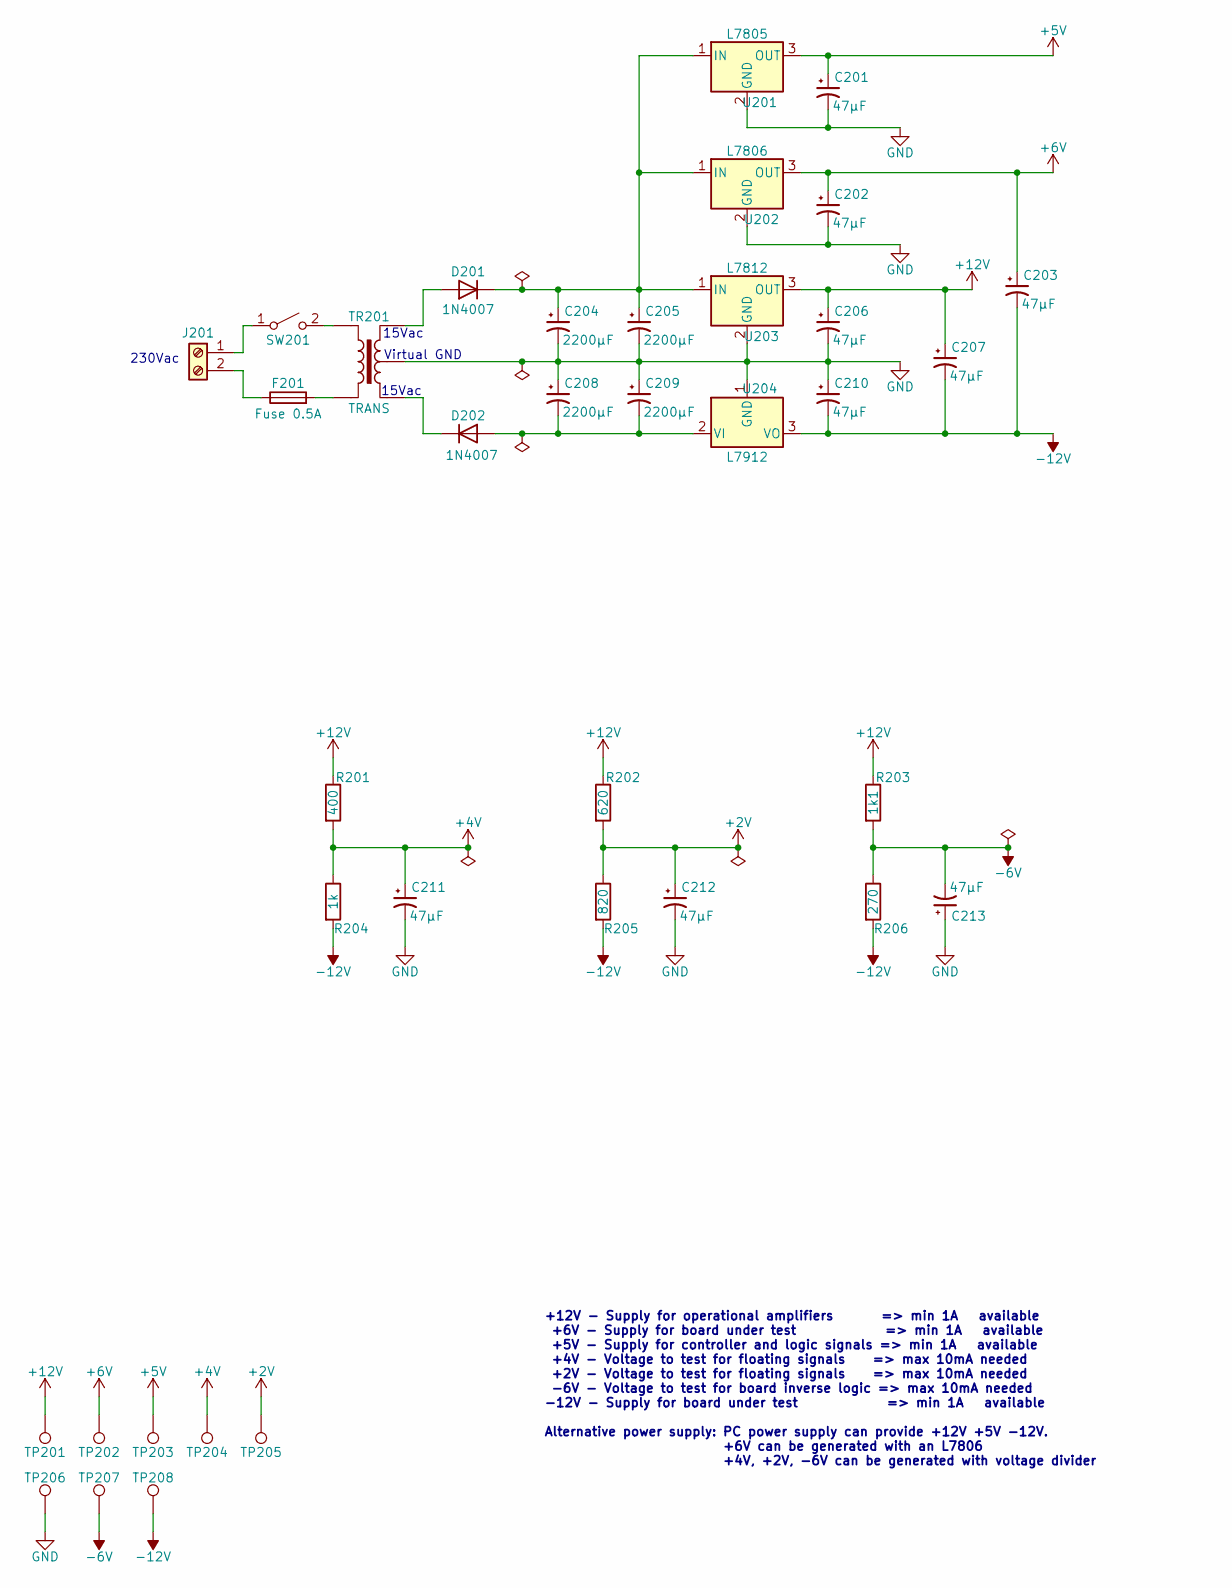
[picture p28: schematic Power_Supply.kicad_sch]

Parts:
C201, C202, C203, C206, C207, C210, C211, C212, C213: 47µF; CP_Radial_D8.0mm_P5.00mm
C204, C205, C208, C209: 2200µF; CP_Radial_D10.0mm_P5.00mm
D201, D202: 1N4007; D_DO-41_SOD81_P10.16mm_Horizontal
F201: Fuse 0.5A; Fuseholder_Clip-5x20mm_Littelfuse_100_Inline_P20.50x4.60mm_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
J201: Screw_Terminal_01x02
R201: 400; R_Axial_DIN0207_L6.3mm_D2.5mm_P7.62mm_Horizontal
R202: 620; R_Axial_DIN0207_L6.3mm_D2.5mm_P7.62mm_Horizontal
R203: 1k1; R_Axial_DIN0207_L6.3mm_D2.5mm_P7.62mm_Horizontal
R204: 1k; R_Axial_DIN0207_L6.3mm_D2.5mm_P7.62mm_Horizontal
R205: 820; R_Axial_DIN0207_L6.3mm_D2.5mm_P7.62mm_Horizontal
R206: 270; R_Axial_DIN0207_L6.3mm_D2.5mm_P7.62mm_Horizontal
SW201: SW_SPST
TP201, TP202, TP203, TP204, TP205, TP206, TP207, TP208: TestPoint; TestPoint_THTPad_D3.0mm_Drill1.5mm
TR201: TRANS
U201: L7805; TO-220-3_Vertical
U202: L7806; TO-220-3_Vertical
U203: L7812; TO-220-3_Vertical
U204: L7912; TO-220-3_Vertical

Connections:
+2V: C212.1, R202.2, R205.1, TP205.1
+4V: C211.1, R201.2, R204.1, TP204.1
+5V: C201.1, TP203.1, U201.3 (OUT)
+6V: C202.1, C203.1, TP202.1, U202.3 (OUT)
+12V: C206.1, C207.1, R201.1, R202.1, R203.1, TP201.1, U203.3 (OUT)
-6V: C213.2, R203.2, R206.1, TP207.1
-12V: C203.2, C207.2, C210.2, R204.2, R205.2, R206.2, TP208.1, U204.3 (VO)
GND: C201.2, C202.2, C204.2, C205.2, C206.2, C208.1, C209.1, C210.1, C211.2, C212.2, C213.1, TP206.1, TR201.2, U201.2 (GND), U202.2 (GND), U203.2 (GND), U204.1 (GND)
unnamed: C204.1, C205.1, D201.1 (K), U201.1 (IN), U202.1 (IN), U203.1 (IN)
unnamed: C208.2, C209.2, D202.2 (A), U204.2 (VI)
unnamed: D201.2 (A), TR201.3
unnamed: D202.1 (K), TR201.1
unnamed: F201.1, J201.2
unnamed: F201.2, TR201.5
unnamed: J201.1, SW201.1 (A)
unnamed: SW201.2 (B), TR201.4

Notes on the sheet:
15Vac
Virtual GND
230Vac
+12V - Supply for operational amplifiers => min 1A available +6V - Supply for board under test => min 1A available +5V - Supply for controller and logic signals => min 1A available +4V - Voltage to test for floating signals => max 10mA needed +2V - Voltage to test for floating signals => max 10mA n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
