Pynckels/versalogic_board_tester/hardware/design/Relay-Driver.kicad_sch

## KiCad design hardware/design/Relay-Driver.kicad_sch (2025-08-26)

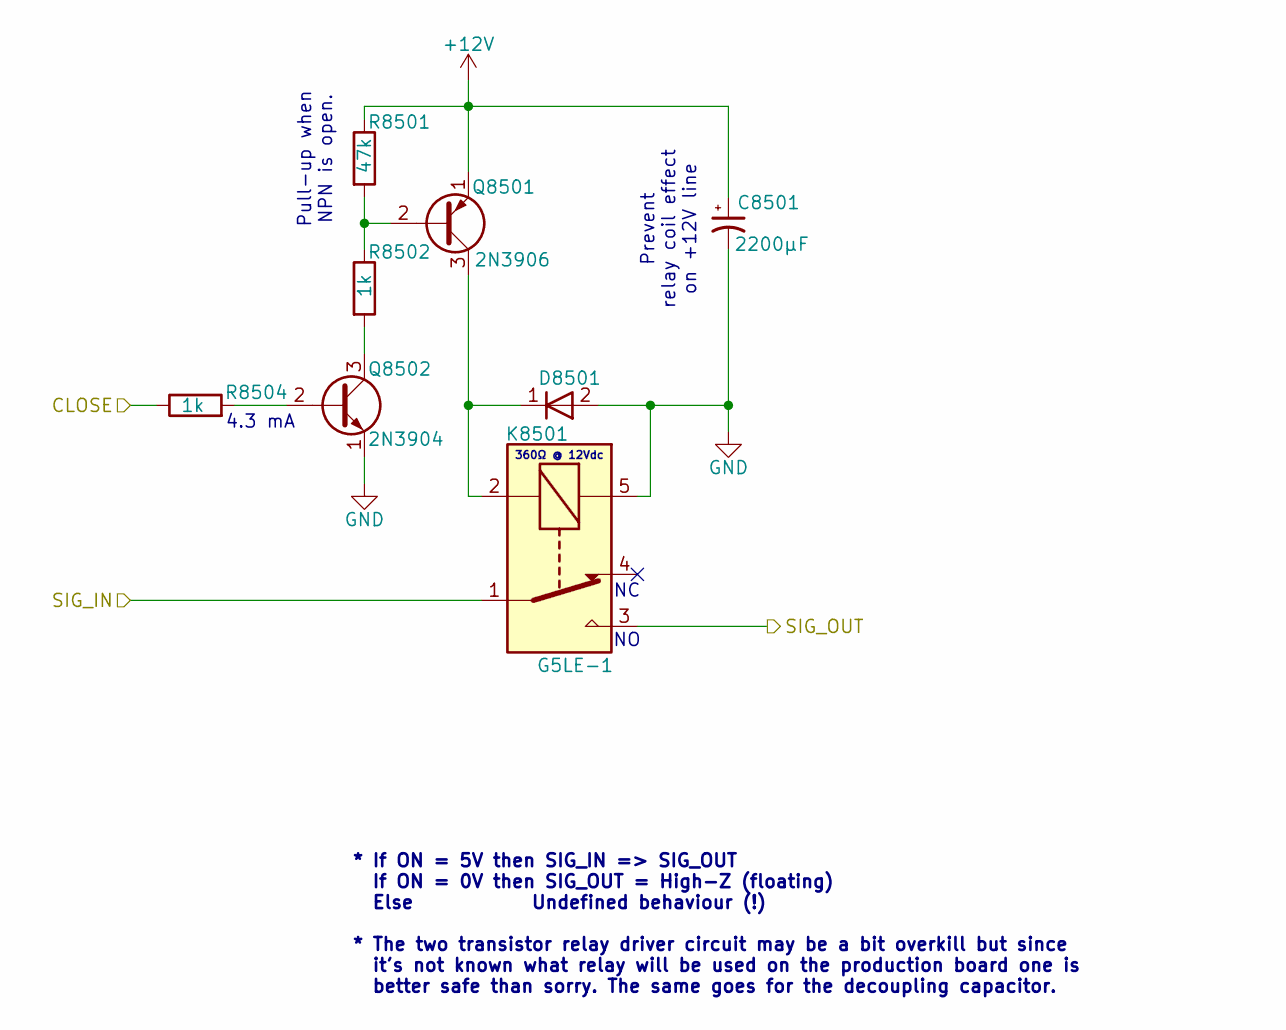
[picture p29: schematic Relay-Driver.kicad_sch]

Parts:
C8501: 2200µF; CP_Radial_D10.0mm_P5.00mm
D8501: D; D_5W_P10.16mm_Horizontal
K8501: G5LE-1; Relay_SPDT_Omron-G5LE-1
Q8501: 2N3906; TO-92_Inline
Q8502: 2N3904; TO-92_Inline
R8501: 47k; R_Axial_DIN0207_L6.3mm_D2.5mm_P7.62mm_Horizontal
R8502, R8504: 1k; R_Axial_DIN0207_L6.3mm_D2.5mm_P7.62mm_Horizontal

Connections:
+12V: C8501.1, Q8501.1 (E), R8501.1
CLOSE: R8504.1
GND: C8501.2, D8501.2 (A), K8501.5, Q8502.1 (E)
unnamed: D8501.1 (K), K8501.2, Q8501.3 (C)
unnamed: Q8501.2 (B), R8501.2, R8502.1
unnamed: Q8502.2 (B), R8504.2
unnamed: Q8502.3 (C), R8502.2
SIG_IN: K8501.1
SIG_OUT: K8501.3

Notes on the sheet:
Prevent relay coil effect on +12V line
4.3 mA
* If ON = 5V then SIG_IN => SIG_OUT If ON = 0V then SIG_OUT = High-Z (floating) Else Undefined behaviour (!) * The two transistor relay driver circuit may be a bit overkill but since it's not known what relay will be used on the production board one is better safe than sorry. The same goes for the 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
360Ω @ 12Vdc
Pull-up when NPN is open.
