Pynckels/versalogic_board_tester/hardware/design/Relay_Driver.kicad_sch

## KiCad design hardware/design/Relay_Driver.kicad_sch (2025-09-06)

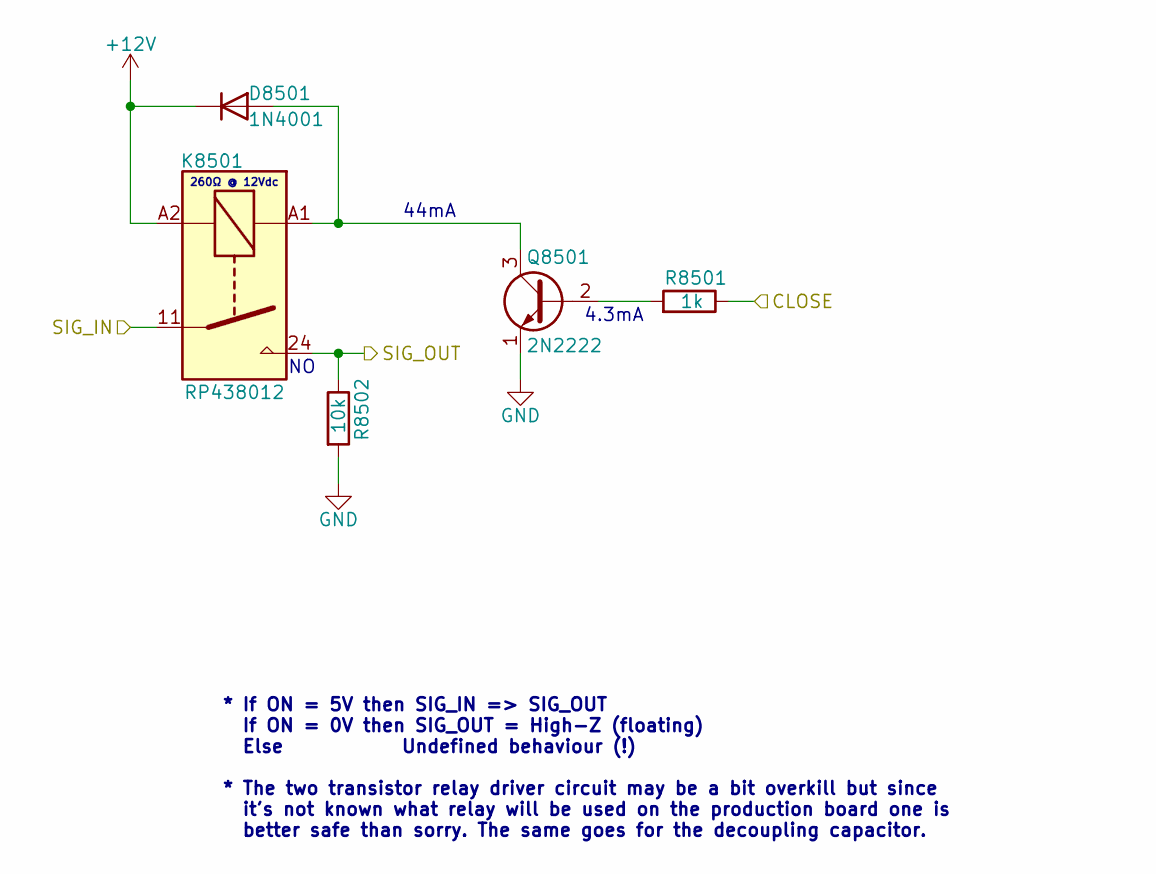
[picture p30: schematic Relay_Driver.kicad_sch]

Parts:
D8501: 1N4001; D_5W_P10.16mm_Horizontal
K8501: RP438012
Q8501: 2N2222; TO-92_Inline
R8501: 1k; R_Axial_DIN0207_L6.3mm_D2.5mm_P7.62mm_Horizontal
R8502: 10k; R_Axial_DIN0207_L6.3mm_D2.5mm_P7.62mm_Horizontal

Connections:
+12V: D8501.1 (K), K8501.A2
CLOSE: R8501.1
GND: Q8501.1 (E), R8502.2
unnamed: D8501.2 (A), K8501.A1, Q8501.3 (C)
unnamed: Q8501.2 (B), R8501.2
SIG_IN: K8501.11
SIG_OUT: K8501.24, R8502.1

Notes on the sheet:
44mA
* If ON = 5V then SIG_IN => SIG_OUT If ON = 0V then SIG_OUT = High-Z (floating) Else Undefined behaviour (!) * The two transistor relay driver circuit may be a bit overkill but since it's not known what relay will be used on the production board one is better safe than sorry. The same goes for the 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
260Ω @ 12Vdc
4.3mA
