Pynckels/versalogic_board_tester/hardware/design/Setter_Getter.kicad_sch

## KiCad design hardware/design/Setter_Getter.kicad_sch (2025-09-06)

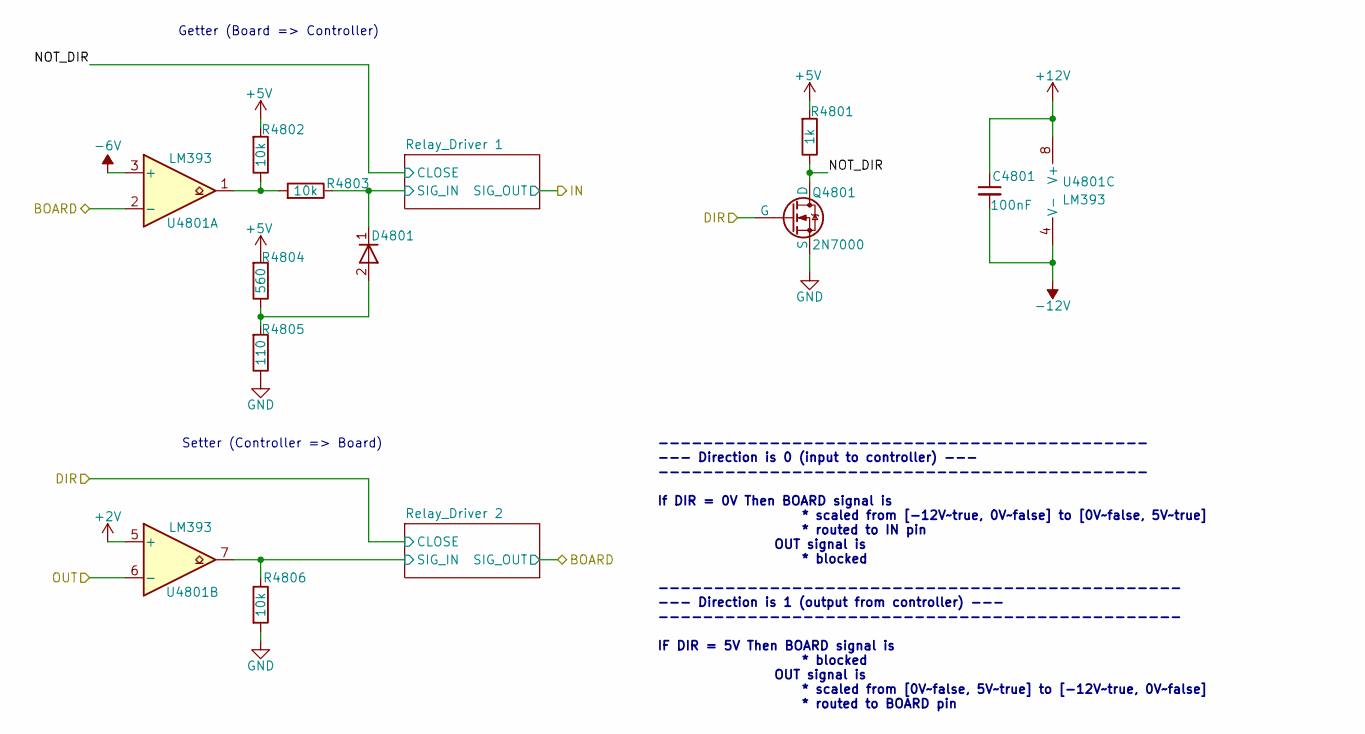
[picture p31: schematic Setter_Getter.kicad_sch]

Parts:
C4801: 100nF; C_Disc_D5.0mm_W2.5mm_P5.00mm
D4801: D; D_5W_P10.16mm_Horizontal
Q4801: 2N7000; TO-92_Inline
R4801: 1k; R_Axial_DIN0207_L6.3mm_D2.5mm_P7.62mm_Horizontal
R4802, R4803, R4806: 10k; R_Axial_DIN0207_L6.3mm_D2.5mm_P7.62mm_Horizontal
R4804: 560; R_Axial_DIN0207_L6.3mm_D2.5mm_P7.62mm_Horizontal
R4805: 110; R_Axial_DIN0207_L6.3mm_D2.5mm_P7.62mm_Horizontal
U4801: LM393; DIP-8_W7.62mm

Connections:
+2V: U4801.5 (+)
+5V: R4801.2, R4802.2, R4804.2
+12V: C4801.1, U4801.8 (V+)
-6V: U4801.3 (+)
-12V: C4801.2, U4801.4 (V-)
BOARD: U4801.2 (-)
DIR: Q4801.2 (G)
GND: Q4801.3 (S), R4805.1, R4806.2
NOT_DIR: Q4801.1 (D), R4801.1
unnamed: D4801.2 (A), R4804.1, R4805.2
unnamed: R4802.1, R4803.2, U4801.1
OUT: U4801.6 (-)
SIG_IN: D4801.1 (K), R4803.1, R4806.1, U4801.7

Notes on the sheet:
-------------------------------------------- --- Direction is 0 (input to controller) --- -------------------------------------------- If DIR = 0V Then BOARD signal is * scaled from [-12V~true, 0V~false] to [0V~false, 5V~true] * routed to IN pin OUT signal is * blocked -----------------------------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
Setter (Controller => Board)
Getter (Board => Controller)
