Pynckels/versalogic_board_tester/hardware/design/Shift_In.kicad_sch

## KiCad design hardware/design/Shift_In.kicad_sch (2025-08-18)

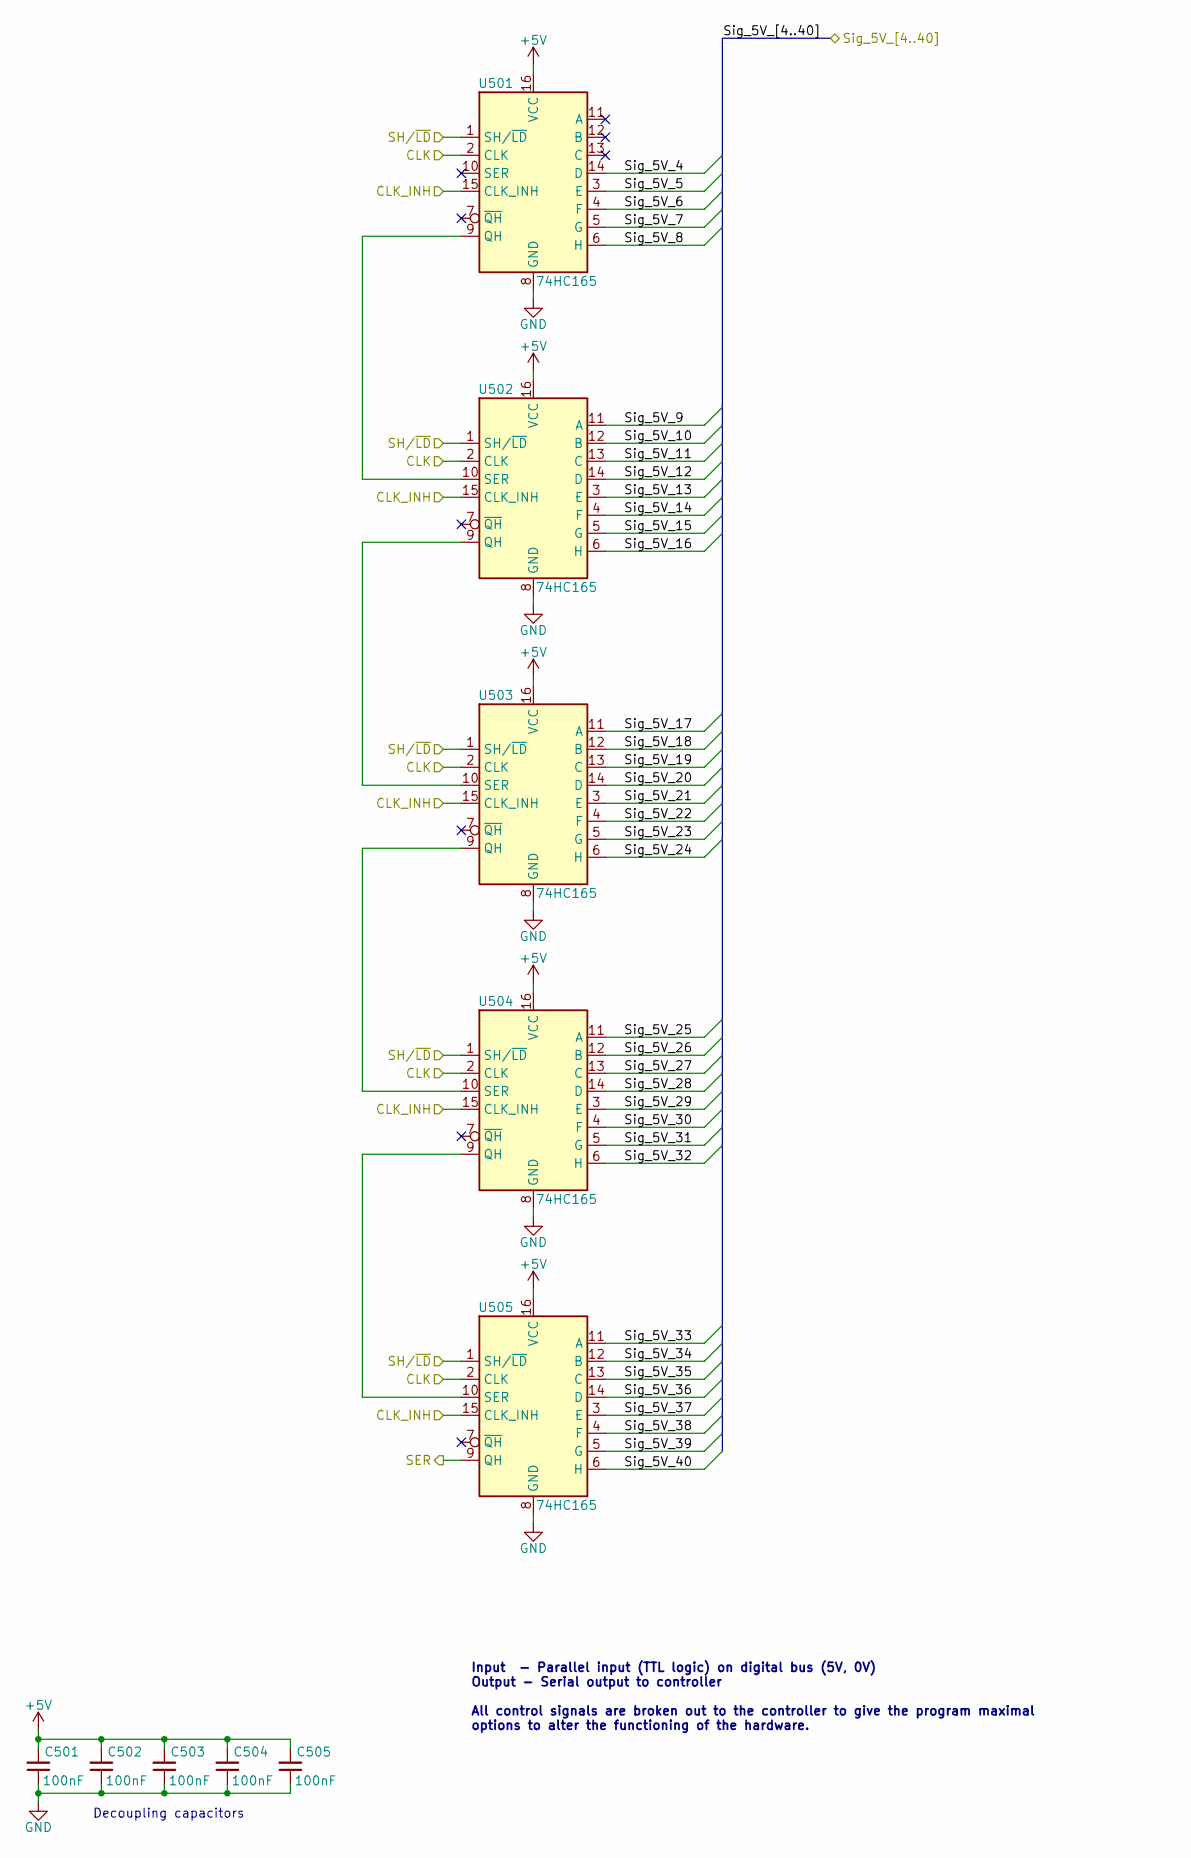
[picture p32: schematic Shift_In.kicad_sch]

Parts:
C501, C502, C503, C504, C505: 100nF; C_Disc_D5.0mm_W2.5mm_P5.00mm
U501, U502, U503, U504, U505: 74HC165; DIP-16_W7.62mm

Connections:
+5V: C501.2, C502.2, C503.2, C504.2, C505.2, U501.16 (VCC), U502.16 (VCC), U503.16 (VCC), U504.16 (VCC), U505.16 (VCC)
CLK: U501.2 (CLK), U502.2 (CLK), U503.2 (CLK), U504.2 (CLK), U505.2 (CLK)
CLK_INH: U501.15 (CLK_INH), U502.15 (CLK_INH), U503.15 (CLK_INH), U504.15 (CLK_INH), U505.15 (CLK_INH)
GND: C501.1, C502.1, C503.1, C504.1, C505.1, U501.8 (GND), U502.8 (GND), U503.8 (GND), U504.8 (GND), U505.8 (GND)
unnamed: U501.9 (QH), U502.10 (SER)
unnamed: U502.9 (QH), U503.10 (SER)
unnamed: U503.9 (QH), U504.10 (SER)
unnamed: U504.9 (QH), U505.10 (SER)
SER: U505.9 (QH)
SH/~LD: U501.1 (SH/~LD), U502.1 (SH/~LD), U503.1 (SH/~LD), U504.1 (SH/~LD), U505.1 (SH/~LD)
Sig_5V_4: U501.14 (D)
Sig_5V_5: U501.3 (E)
Sig_5V_6: U501.4 (F)
Sig_5V_7: U501.5 (G)
Sig_5V_8: U501.6 (H)
Sig_5V_9: U502.11 (A)
Sig_5V_10: U502.12 (B)
Sig_5V_11: U502.13 (C)
Sig_5V_12: U502.14 (D)
Sig_5V_13: U502.3 (E)
Sig_5V_14: U502.4 (F)
Sig_5V_15: U502.5 (G)
Sig_5V_16: U502.6 (H)
Sig_5V_17: U503.11 (A)
Sig_5V_18: U503.12 (B)
Sig_5V_19: U503.13 (C)
Sig_5V_20: U503.14 (D)
Sig_5V_21: U503.3 (E)
Sig_5V_22: U503.4 (F)
Sig_5V_23: U503.5 (G)
Sig_5V_24: U503.6 (H)
Sig_5V_25: U504.11 (A)
Sig_5V_26: U504.12 (B)
Sig_5V_27: U504.13 (C)
Sig_5V_28: U504.14 (D)
Sig_5V_29: U504.3 (E)
Sig_5V_30: U504.4 (F)
Sig_5V_31: U504.5 (G)
Sig_5V_32: U504.6 (H)
Sig_5V_33: U505.11 (A)
Sig_5V_34: U505.12 (B)
Sig_5V_35: U505.13 (C)
Sig_5V_36: U505.14 (D)
Sig_5V_37: U505.3 (E)
Sig_5V_38: U505.4 (F)
Sig_5V_39: U505.5 (G)
Sig_5V_40: U505.6 (H)

Notes on the sheet:
Input - Parallel input (TTL logic) on digital bus (5V, 0V) Output - Serial output to controller All control signals are broken out to the controller to give the program maximal options to alter the functioning of the hardware.
Decoupling capacitors
