Pynckels/versalogic_board_tester/hardware/design/Shift_Out.kicad_sch

## KiCad design hardware/design/Shift_Out.kicad_sch (2025-08-18)

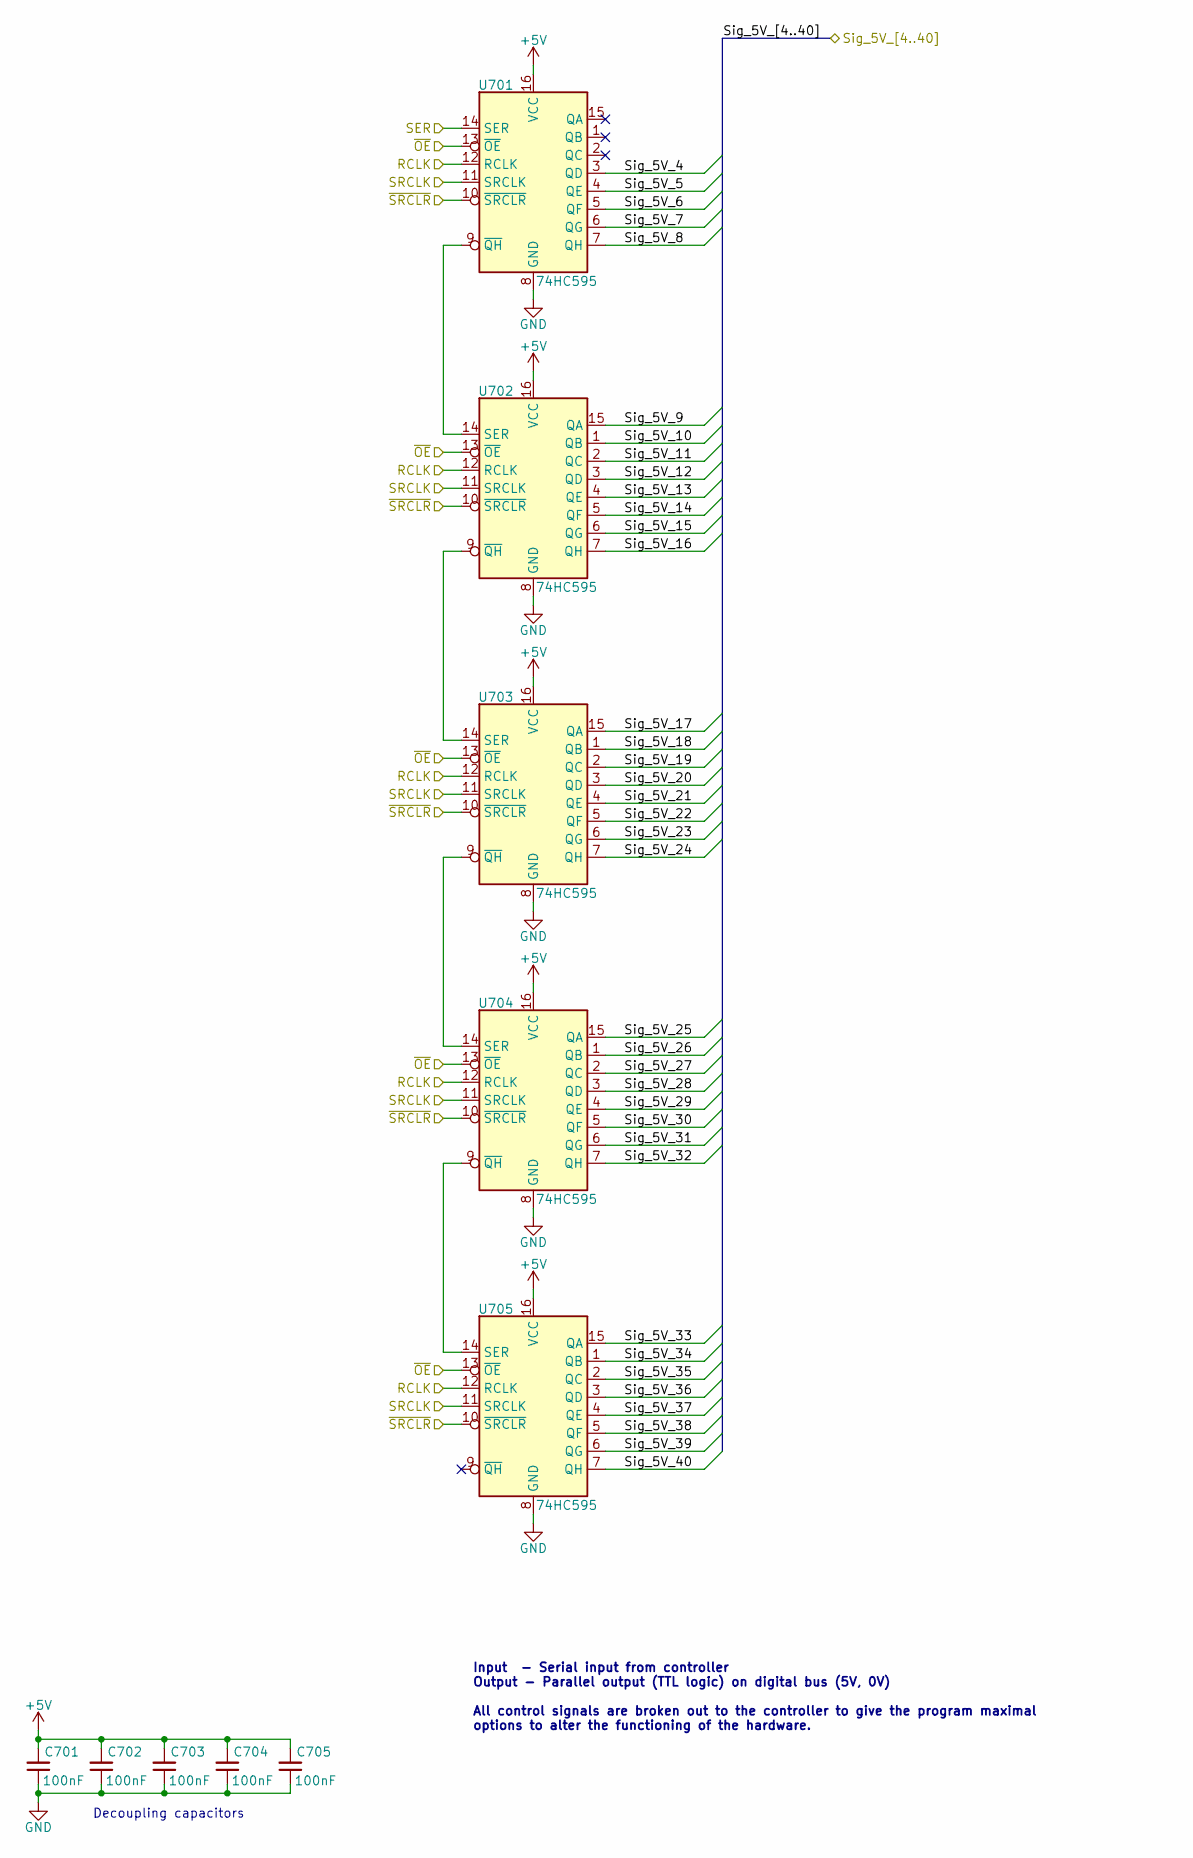
[picture p33: schematic Shift_Out.kicad_sch]

Parts:
C701, C702, C703, C704, C705: 100nF; C_Disc_D5.0mm_W2.5mm_P5.00mm
U701, U702, U703, U704, U705: 74HC595; DIP-16_W7.62mm

Connections:
+5V: C701.2, C702.2, C703.2, C704.2, C705.2, U701.16 (VCC), U702.16 (VCC), U703.16 (VCC), U704.16 (VCC), U705.16 (VCC)
GND: C701.1, C702.1, C703.1, C704.1, C705.1, U701.8 (GND), U702.8 (GND), U703.8 (GND), U704.8 (GND), U705.8 (GND)
unnamed: U701.9 (~QH), U702.14 (SER)
unnamed: U702.9 (~QH), U703.14 (SER)
unnamed: U703.9 (~QH), U704.14 (SER)
unnamed: U704.9 (~QH), U705.14 (SER)
RCLK: U701.12 (RCLK), U702.12 (RCLK), U703.12 (RCLK), U704.12 (RCLK), U705.12 (RCLK)
SER: U701.14 (SER)
SRCLK: U701.11 (SRCLK), U702.11 (SRCLK), U703.11 (SRCLK), U704.11 (SRCLK), U705.11 (SRCLK)
Sig_5V_4: U701.3 (QD)
Sig_5V_5: U701.4 (QE)
Sig_5V_6: U701.5 (QF)
Sig_5V_7: U701.6 (QG)
Sig_5V_8: U701.7 (QH)
Sig_5V_9: U702.15 (QA)
Sig_5V_10: U702.1 (QB)
Sig_5V_11: U702.2 (QC)
Sig_5V_12: U702.3 (QD)
Sig_5V_13: U702.4 (QE)
Sig_5V_14: U702.5 (QF)
Sig_5V_15: U702.6 (QG)
Sig_5V_16: U702.7 (QH)
Sig_5V_17: U703.15 (QA)
Sig_5V_18: U703.1 (QB)
Sig_5V_19: U703.2 (QC)
Sig_5V_20: U703.3 (QD)
Sig_5V_21: U703.4 (QE)
Sig_5V_22: U703.5 (QF)
Sig_5V_23: U703.6 (QG)
Sig_5V_24: U703.7 (QH)
Sig_5V_25: U704.15 (QA)
Sig_5V_26: U704.1 (QB)
Sig_5V_27: U704.2 (QC)
Sig_5V_28: U704.3 (QD)
Sig_5V_29: U704.4 (QE)
Sig_5V_30: U704.5 (QF)
Sig_5V_31: U704.6 (QG)
Sig_5V_32: U704.7 (QH)
Sig_5V_33: U705.15 (QA)
Sig_5V_34: U705.1 (QB)
Sig_5V_35: U705.2 (QC)
Sig_5V_36: U705.3 (QD)
Sig_5V_37: U705.4 (QE)
Sig_5V_38: U705.5 (QF)
Sig_5V_39: U705.6 (QG)
Sig_5V_40: U705.7 (QH)
~OE: U701.13 (~OE), U702.13 (~OE), U703.13 (~OE), U704.13 (~OE), U705.13 (~OE)
~SRCLR: U701.10 (~SRCLR), U702.10 (~SRCLR), U703.10 (~SRCLR), U704.10 (~SRCLR), U705.10 (~SRCLR)

Notes on the sheet:
Decoupling capacitors
Input - Serial input from controller Output - Parallel output (TTL logic) on digital bus (5V, 0V) All control signals are broken out to the controller to give the program maximal options to alter the functioning of the hardware.
