Pynckels/versalogic_board_tester/hardware/design/Window_Comparator.kicad_sch

## KiCad design hardware/design/Window_Comparator.kicad_sch (2025-09-06)

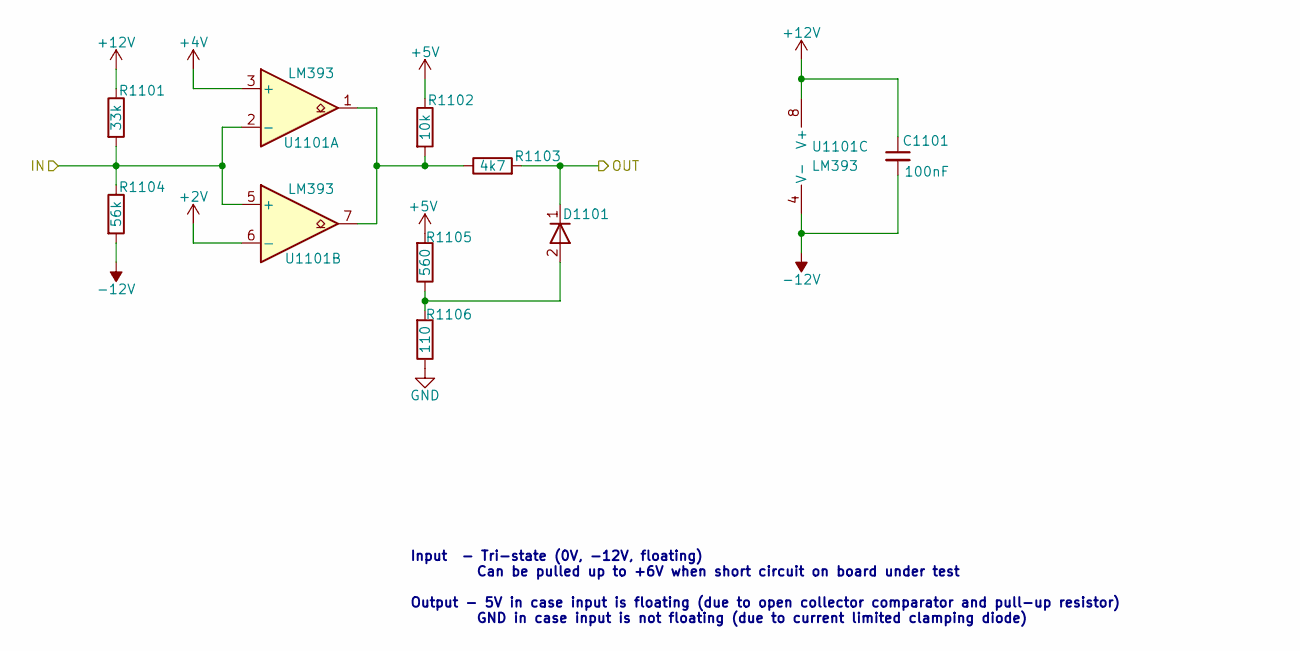
[picture p34: schematic Window_Comparator.kicad_sch]

Parts:
C1101: 100nF; C_Disc_D5.0mm_W2.5mm_P5.00mm
D1101: D; D_5W_P10.16mm_Horizontal
R1101: 33k; R_Axial_DIN0207_L6.3mm_D2.5mm_P7.62mm_Horizontal
R1102: 10k; R_Axial_DIN0207_L6.3mm_D2.5mm_P7.62mm_Horizontal
R1103: 4k7; R_Axial_DIN0207_L6.3mm_D2.5mm_P7.62mm_Horizontal
R1104: 56k; R_Axial_DIN0207_L6.3mm_D2.5mm_P7.62mm_Horizontal
R1105: 560; R_Axial_DIN0207_L6.3mm_D2.5mm_P7.62mm_Horizontal
R1106: 110; R_Axial_DIN0207_L6.3mm_D2.5mm_P7.62mm_Horizontal
U1101: LM393; DIP-8_W7.62mm

Connections:
+2V: U1101.6 (-)
+4V: U1101.3 (+)
+5V: R1102.1, R1105.2
+12V: C1101.1, R1101.1, U1101.8 (V+)
-12V: C1101.2, R1104.2, U1101.4 (V-)
GND: R1106.1
IN: R1101.2, R1104.1, U1101.2 (-), U1101.5 (+)
unnamed: D1101.2 (A), R1105.1, R1106.2
unnamed: R1102.2, R1103.1, U1101.1, U1101.7
OUT: D1101.1 (K), R1103.2

Notes on the sheet:
Input - Tri-state (0V, -12V, floating) Can be pulled up to +6V when short circuit on board under test Output - 5V in case input is floating (due to open collector comparator and pull-up resistor) GND in case input is not floating (due to current limited clamping diode)
