Pynckels/versalogic_board_tester/hardware/proofs_of_concept/Cascaded_74xx165/Cascaded_74xx165.kicad_sch

## KiCad design hardware/proofs_of_concept/Cascaded_74xx165/Cascaded_74xx165.kicad_sch (2025-08-31)

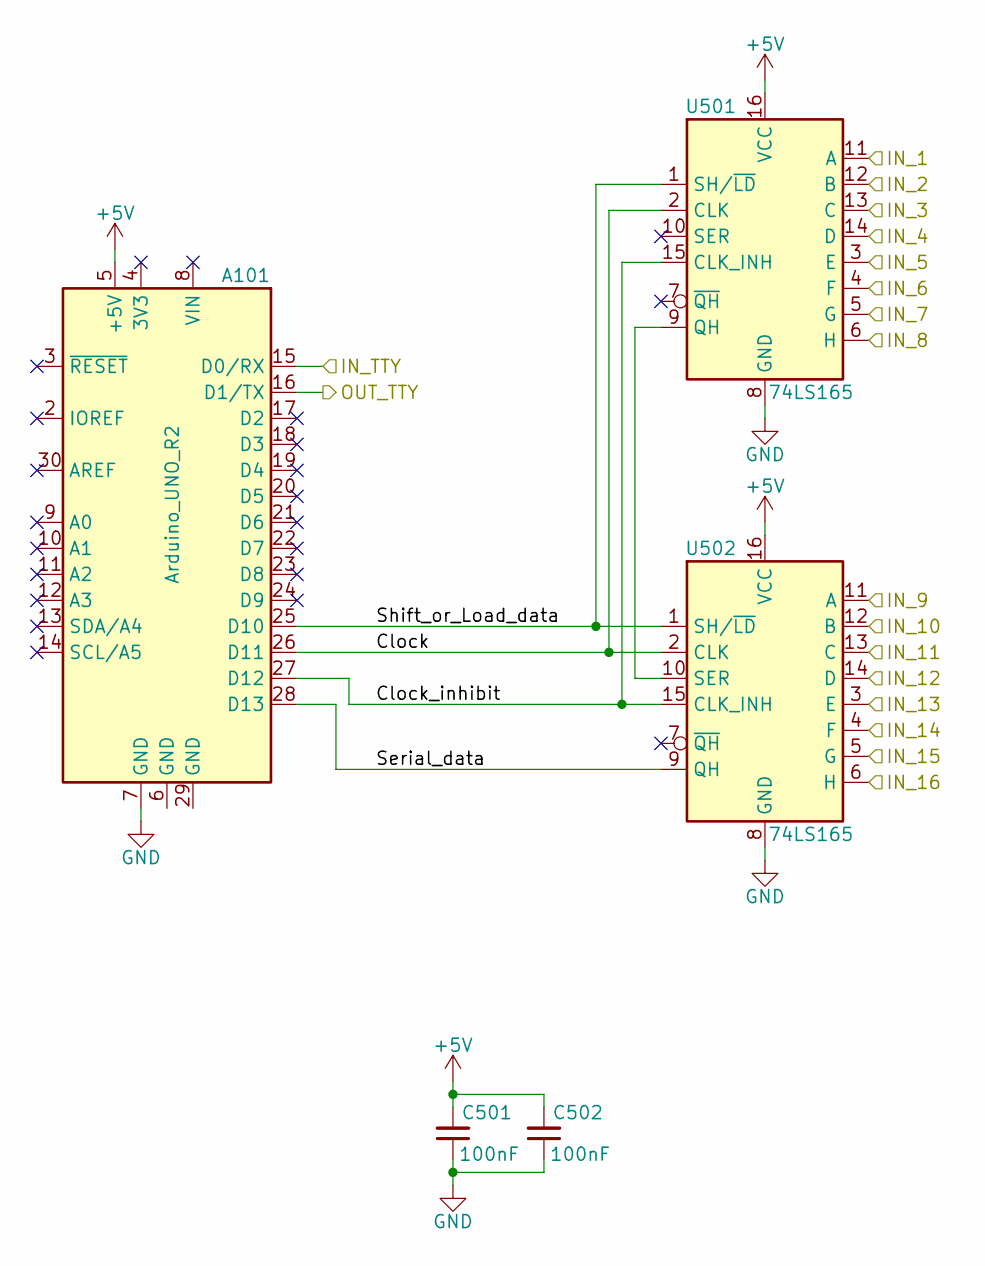
[picture p35: schematic Cascaded_74xx165.kicad_sch]

Parts:
A101: Arduino_UNO_R2
C501, C502: 100nF; C_Disc_D5.0mm_W2.5mm_P5.00mm
U501, U502: 74LS165; DIP-16_W7.62mm

Connections:
+5V: A101.5 (+5V), C501.2, C502.2, U501.16 (VCC), U502.16 (VCC)
Clock: A101.26 (D11), U501.2 (CLK), U502.2 (CLK)
Clock_inhibit: A101.27 (D12), U501.15 (CLK_INH), U502.15 (CLK_INH)
GND: A101.7 (GND), C501.1, C502.1, U501.8 (GND), U502.8 (GND)
IN_1: U501.11 (A)
IN_2: U501.12 (B)
IN_3: U501.13 (C)
IN_4: U501.14 (D)
IN_5: U501.3 (E)
IN_6: U501.4 (F)
IN_7: U501.5 (G)
IN_8: U501.6 (H)
IN_9: U502.11 (A)
IN_10: U502.12 (B)
IN_11: U502.13 (C)
IN_12: U502.14 (D)
IN_13: U502.3 (E)
IN_14: U502.4 (F)
IN_15: U502.5 (G)
IN_16: U502.6 (H)
IN_TTY: A101.15 (D0/RX)
unnamed: U501.9 (QH), U502.10 (SER)
OUT_TTY: A101.16 (D1/TX)
Serial_data: A101.28 (D13), U502.9 (QH)
Shift_or_Load_data: A101.25 (D10), U501.1 (SH/~LD), U502.1 (SH/~LD)
