Pynckels/versalogic_board_tester/hardware/proofs_of_concept/Cascaded_74xx595/Cascaded_74xx595.kicad_sch

## KiCad design hardware/proofs_of_concept/Cascaded_74xx595/Cascaded_74xx595.kicad_sch (2025-08-31)

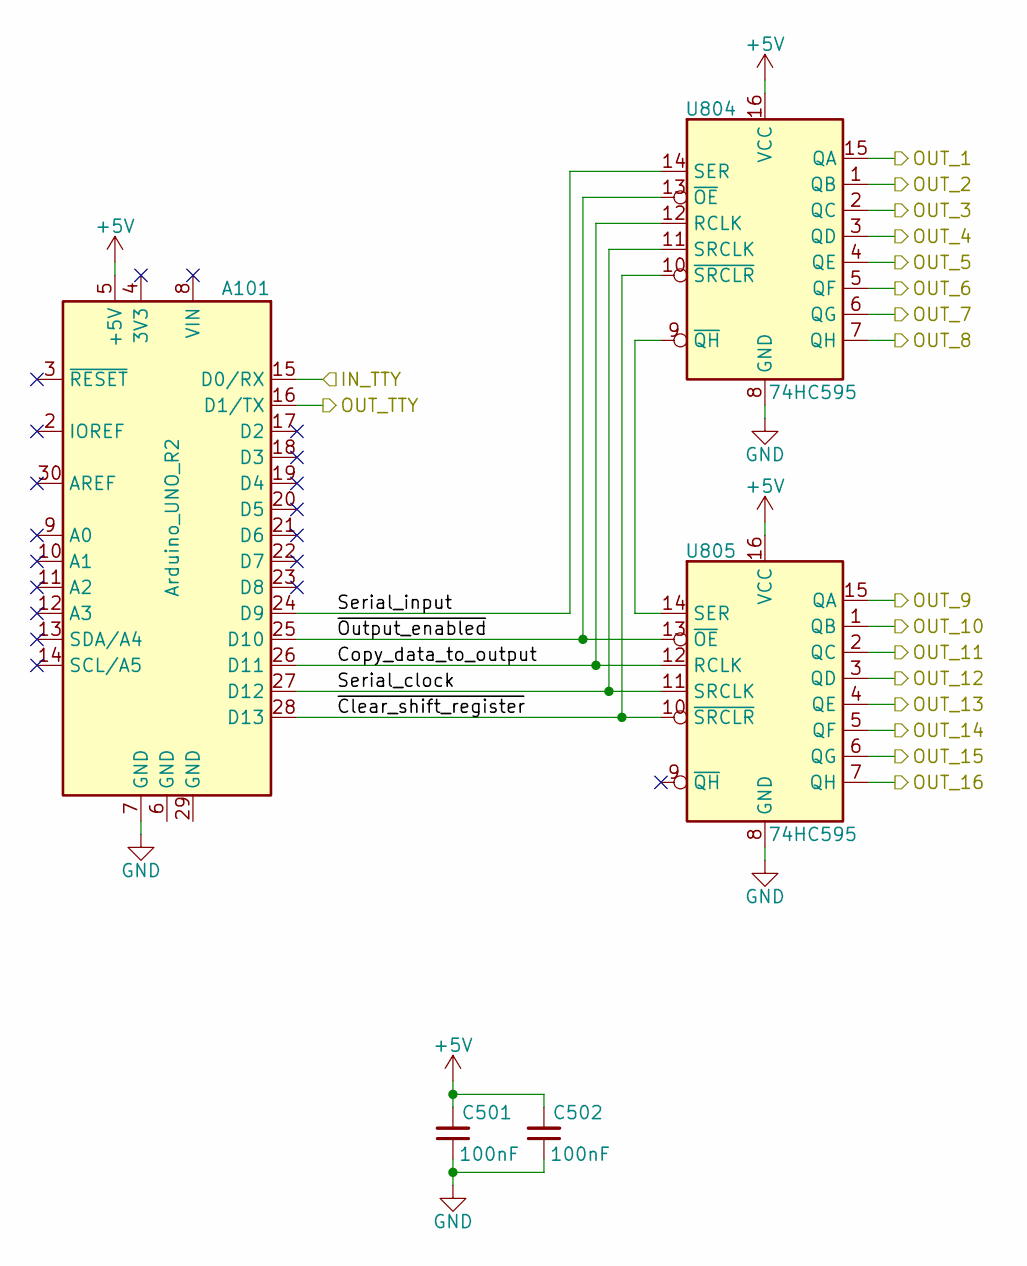
[picture p36: schematic Cascaded_74xx595.kicad_sch]

Parts:
A101: Arduino_UNO_R2
C501, C502: 100nF; C_Disc_D5.0mm_W2.5mm_P5.00mm
U804, U805: 74HC595; DIP-16_W7.62mm

Connections:
+5V: A101.5 (+5V), C501.2, C502.2, U804.16 (VCC), U805.16 (VCC)
Copy_data_to_output: A101.26 (D11), U804.12 (RCLK), U805.12 (RCLK)
GND: A101.7 (GND), C501.1, C502.1, U804.8 (GND), U805.8 (GND)
IN_TTY: A101.15 (D0/RX)
unnamed: U804.9 (~QH), U805.14 (SER)
OUT_1: U804.15 (QA)
OUT_2: U804.1 (QB)
OUT_3: U804.2 (QC)
OUT_4: U804.3 (QD)
OUT_5: U804.4 (QE)
OUT_6: U804.5 (QF)
OUT_7: U804.6 (QG)
OUT_8: U804.7 (QH)
OUT_9: U805.15 (QA)
OUT_10: U805.1 (QB)
OUT_11: U805.2 (QC)
OUT_12: U805.3 (QD)
OUT_13: U805.4 (QE)
OUT_14: U805.5 (QF)
OUT_15: U805.6 (QG)
OUT_16: U805.7 (QH)
OUT_TTY: A101.16 (D1/TX)
Serial_clock: A101.27 (D12), U804.11 (SRCLK), U805.11 (SRCLK)
Serial_input: A101.24 (D9), U804.14 (SER)
~Clear_shift_register: A101.28 (D13), U804.10 (~SRCLR), U805.10 (~SRCLR)
~Output_enabled: A101.25 (D10), U804.13 (~OE), U805.13 (~OE)
