Pynckels/versalogic_board_tester/hardware/proofs_of_concept/Relay_Driver/Relay_Driver.kicad_sch

## KiCad design hardware/proofs_of_concept/Relay_Driver/Relay_Driver.kicad_sch (2025-09-06)

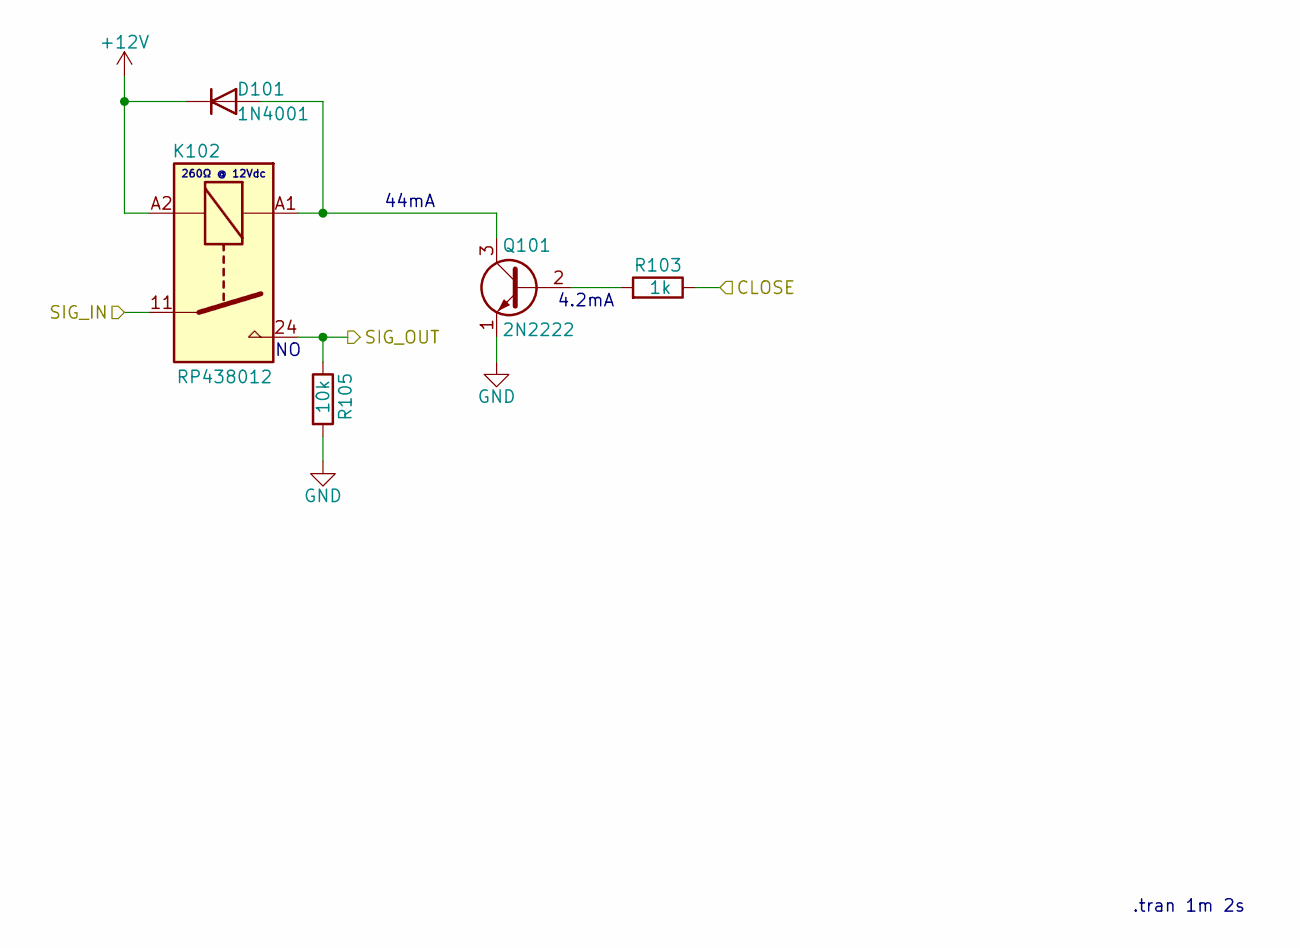
[picture p37: schematic Relay_Driver.kicad_sch]

Parts:
D101: 1N4001
K102: RP438012; Relay_SPST_Omron_G2RL-1A
Q101: 2N2222; TO-92_Inline
R103: 1k; R_Axial_DIN0207_L6.3mm_D2.5mm_P7.62mm_Horizontal
R105: 10k; R_Axial_DIN0207_L6.3mm_D2.5mm_P7.62mm_Horizontal

Connections:
+12V: D101.1 (K), K102.A2
CLOSE: R103.1
GND: Q101.1 (E), R105.2
unnamed: D101.2 (A), K102.A1, Q101.3 (C)
unnamed: Q101.2 (B), R103.2
SIG_IN: K102.11
SIG_OUT: K102.24, R105.1

Notes on the sheet:
4.2mA
260Ω @ 12Vdc
.tran 1m 2s
44mA
