Pynckels/versalogic_board_tester/hardware/proofs_of_concept/Window_Comparator/Window_Comparator.kicad_sch

## KiCad design hardware/proofs_of_concept/Window_Comparator/Window_Comparator.kicad_sch (2025-09-05)

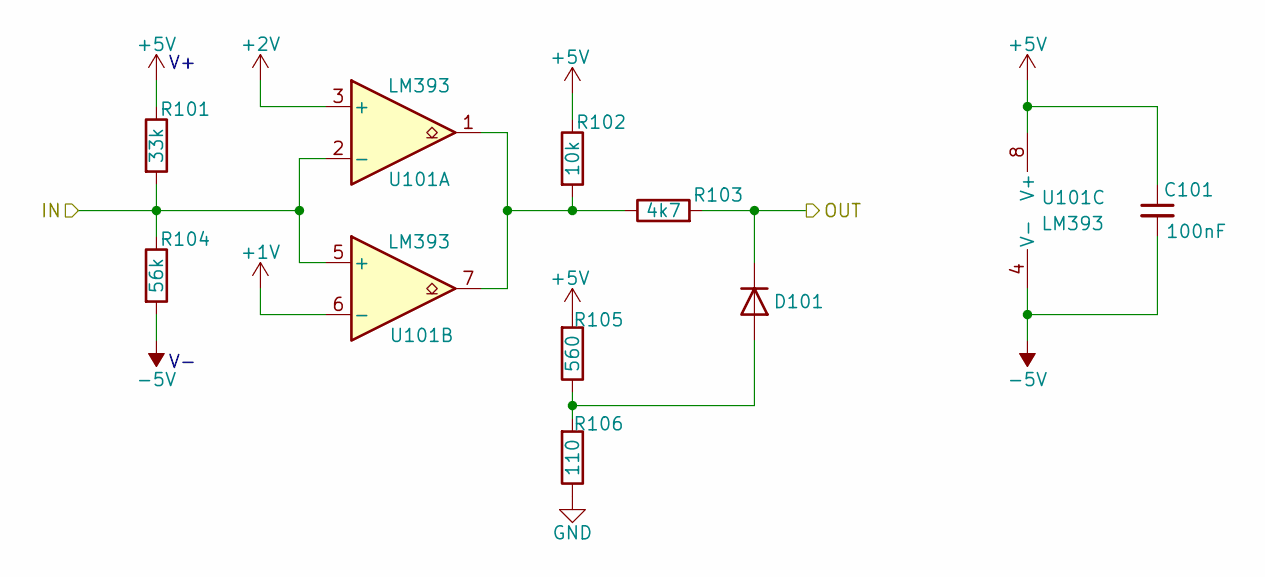
[picture p38: schematic Window_Comparator.kicad_sch]

Parts:
C101: 100nF; C_Disc_D5.0mm_W2.5mm_P5.00mm
D101: D
R101: 33k; R_Axial_DIN0207_L6.3mm_D2.5mm_P7.62mm_Horizontal
R102: 10k; R_Axial_DIN0207_L6.3mm_D2.5mm_P7.62mm_Horizontal
R103: 4k7; R_Axial_DIN0207_L6.3mm_D2.5mm_P7.62mm_Horizontal
R104: 56k; R_Axial_DIN0207_L6.3mm_D2.5mm_P7.62mm_Horizontal
R105: 560; R_Axial_DIN0207_L6.3mm_D2.5mm_P7.62mm_Horizontal
R106: 110; R_Axial_DIN0207_L6.3mm_D2.5mm_P7.62mm_Horizontal
U101: LM393; DIP-8_W7.62mm

Connections:
+1V: U101.6 (-)
+2V: U101.3 (+)
+5V: C101.1, R101.1, R102.1, R105.2, U101.8 (V+)
-5V: C101.2, R104.2, U101.4 (V-)
GND: R106.1
IN: R101.2, R104.1, U101.2 (-), U101.5 (+)
unnamed: D101.2 (A), R105.1, R106.2
unnamed: R102.2, R103.1, U101.1, U101.7
OUT: D101.1 (K), R103.2
