Pynckels/versalogic_board_tester/hardware/simulations/Power_Supply/Power_Supply.kicad_sch

## KiCad design hardware/simulations/Power_Supply/Power_Supply.kicad_sch (2025-08-26)

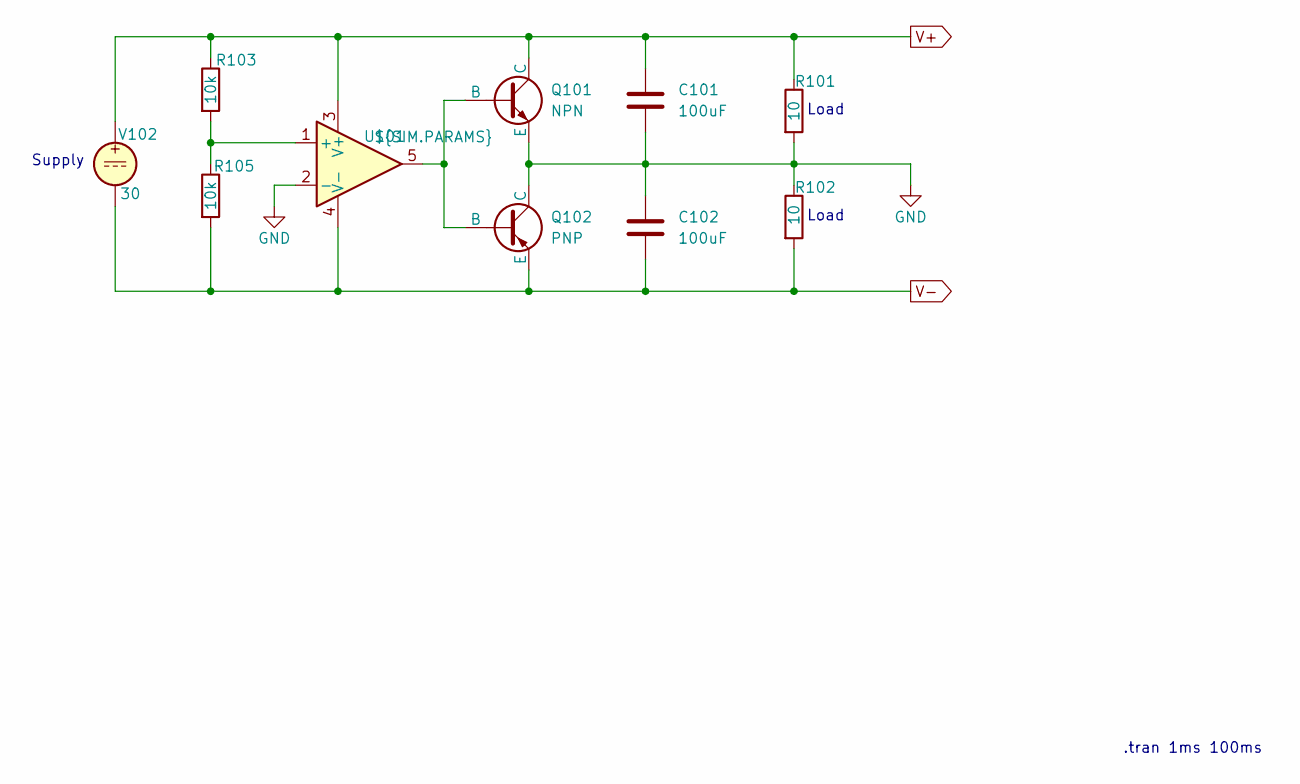
[picture p39: schematic Power_Supply.kicad_sch]

Parts:
C101, C102: 100uF
Q101: NPN
Q102: PNP
R101, R102: 10
R103, R105: 10k
U101: ${SIM.PARAMS}
V102: 30

Connections:
GND: C101.2, C102.1, Q101.3 (E), Q102.1 (C), R101.2, R102.1, U101.2 (-)
unnamed: Q101.2 (B), Q102.2 (B), U101.5
unnamed: R103.2, R105.1, U101.1 (+)
V+: C101.1, Q101.1 (C), R101.1, R103.1, U101.3 (V+), V102.1
V-: C102.2, Q102.3 (E), R102.2, R105.2, U101.4 (V-), V102.2

Notes on the sheet:
Load
Supply
.tran 1ms 100ms
