Pynckels/versalogic_board_tester/hardware/simulations/Setter_Getter/Setter_Getter.kicad_sch

## KiCad design hardware/simulations/Setter_Getter/Setter_Getter.kicad_sch (2025-08-13)

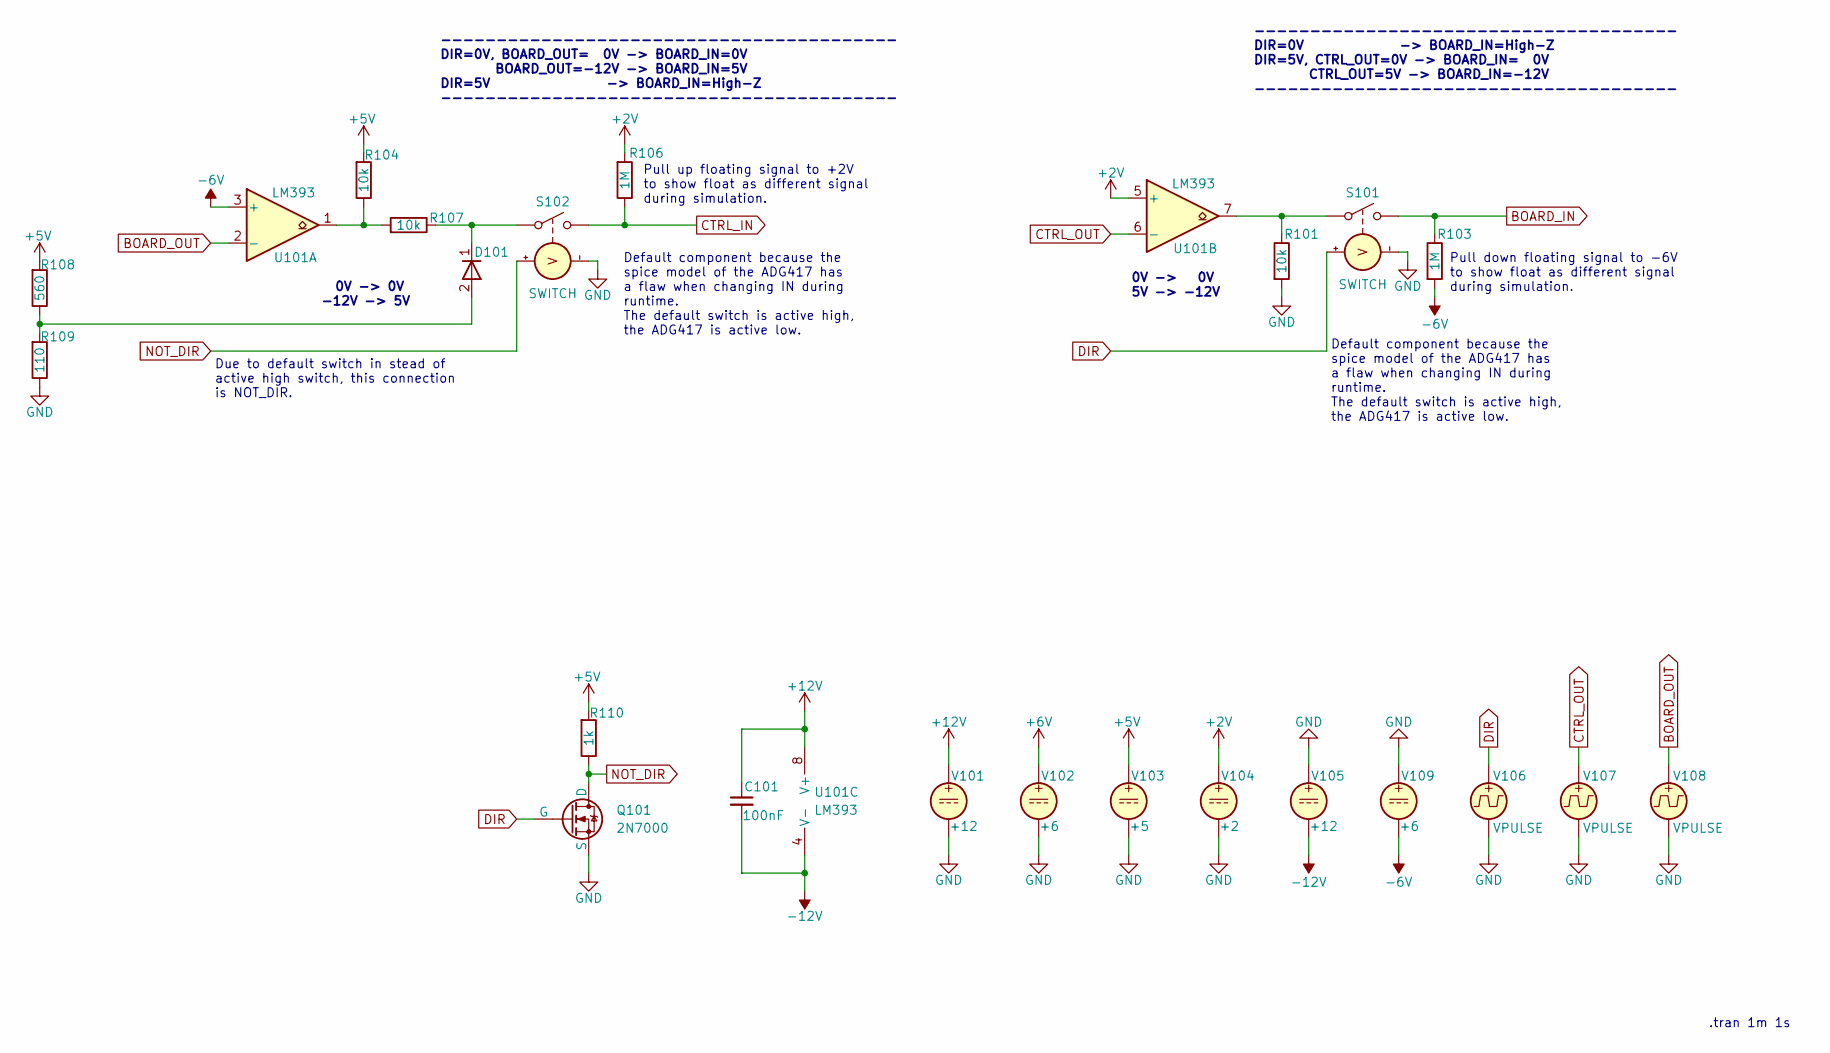
[picture p40: schematic Setter_Getter.kicad_sch]

Parts:
C101: 100nF; C_Disc_D5.0mm_W2.5mm_P5.00mm
D101: D
Q101: 2N7000
R101, R104, R107: 10k; R_Axial_DIN0207_L6.3mm_D2.5mm_P7.62mm_Horizontal
R103, R106: 1M; R_Axial_DIN0207_L6.3mm_D2.5mm_P7.62mm_Horizontal
R108: 560; R_Axial_DIN0207_L6.3mm_D2.5mm_P7.62mm_Horizontal
R109: 110; R_Axial_DIN0207_L6.3mm_D2.5mm_P7.62mm_Horizontal
R110: 1k; R_Axial_DIN0207_L6.3mm_D2.5mm_P7.62mm_Horizontal
S101, S102: SWITCH
U101: LM393; DIP-8_W7.62mm
V101, V105: +12
V102, V109: +6
V103: +5
V104: +2
V106, V107, V108: VPULSE

Connections:
+2V: R106.2, U101.5 (+), V104.1
+5V: R104.2, R108.2, R110.2, V103.1
+6V: V102.1
+12V: C101.1, U101.8 (V+), V101.1
-6V: R103.2, U101.3 (+), V109.2
-12V: C101.2, U101.4 (V-), V105.2
BOARD_IN: R103.1, S101.2 (N-)
BOARD_OUT: U101.2 (-), V108.1
CTRL_IN: R106.1, S102.2 (N-)
CTRL_OUT: U101.6 (-), V107.1
DIR: Q101.2 (G), S101.3 (C+), V106.1
GND: Q101.3 (S), R101.2, R109.1, S101.4 (C-), S102.4 (C-), V101.2, V102.2, V103.2, V104.2, V105.1, V106.2, V107.2, V108.2, V109.1
NOT_DIR: Q101.1 (D), R110.1, S102.3 (C+)
unnamed: D101.1 (K), R107.1, S102.1 (N+)
unnamed: D101.2 (A), R108.1, R109.2
unnamed: R101.1, S101.1 (N+), U101.7
unnamed: R104.1, R107.2, U101.1

Notes on the sheet:
0V -> 0V -12V -> 5V
----------------------------------------- DIR=0V, BOARD_OUT= 0V -> BOARD_IN=0V BOARD_OUT=-12V -> BOARD_IN=5V DIR=5V -> BOARD_IN=High-Z -----------------------------------------
-------------------------------------- DIR=0V -> BOARD_IN=High-Z DIR=5V, CTRL_OUT=0V -> BOARD_IN= 0V CTRL_OUT=5V -> BOARD_IN=-12V --------------------------------------
Due to default switch in stead of active high switch, this connection is NOT_DIR.
0V -> 0V 5V -> -12V
Default component because the spice model of the ADG417 has a flaw when changing IN during runtime. The default switch is active high, the ADG417 is active low.
.tran 1m 1s
Pull down floating signal to -6V to show float as different signal during simulation.
Pull up floating signal to +2V to show float as different signal during simulation.
