Pynckels/versalogic_board_tester/hardware/simulations/Window_Comparator/Window_Comparator.kicad_sch

## KiCad design hardware/simulations/Window_Comparator/Window_Comparator.kicad_sch (2025-08-28)

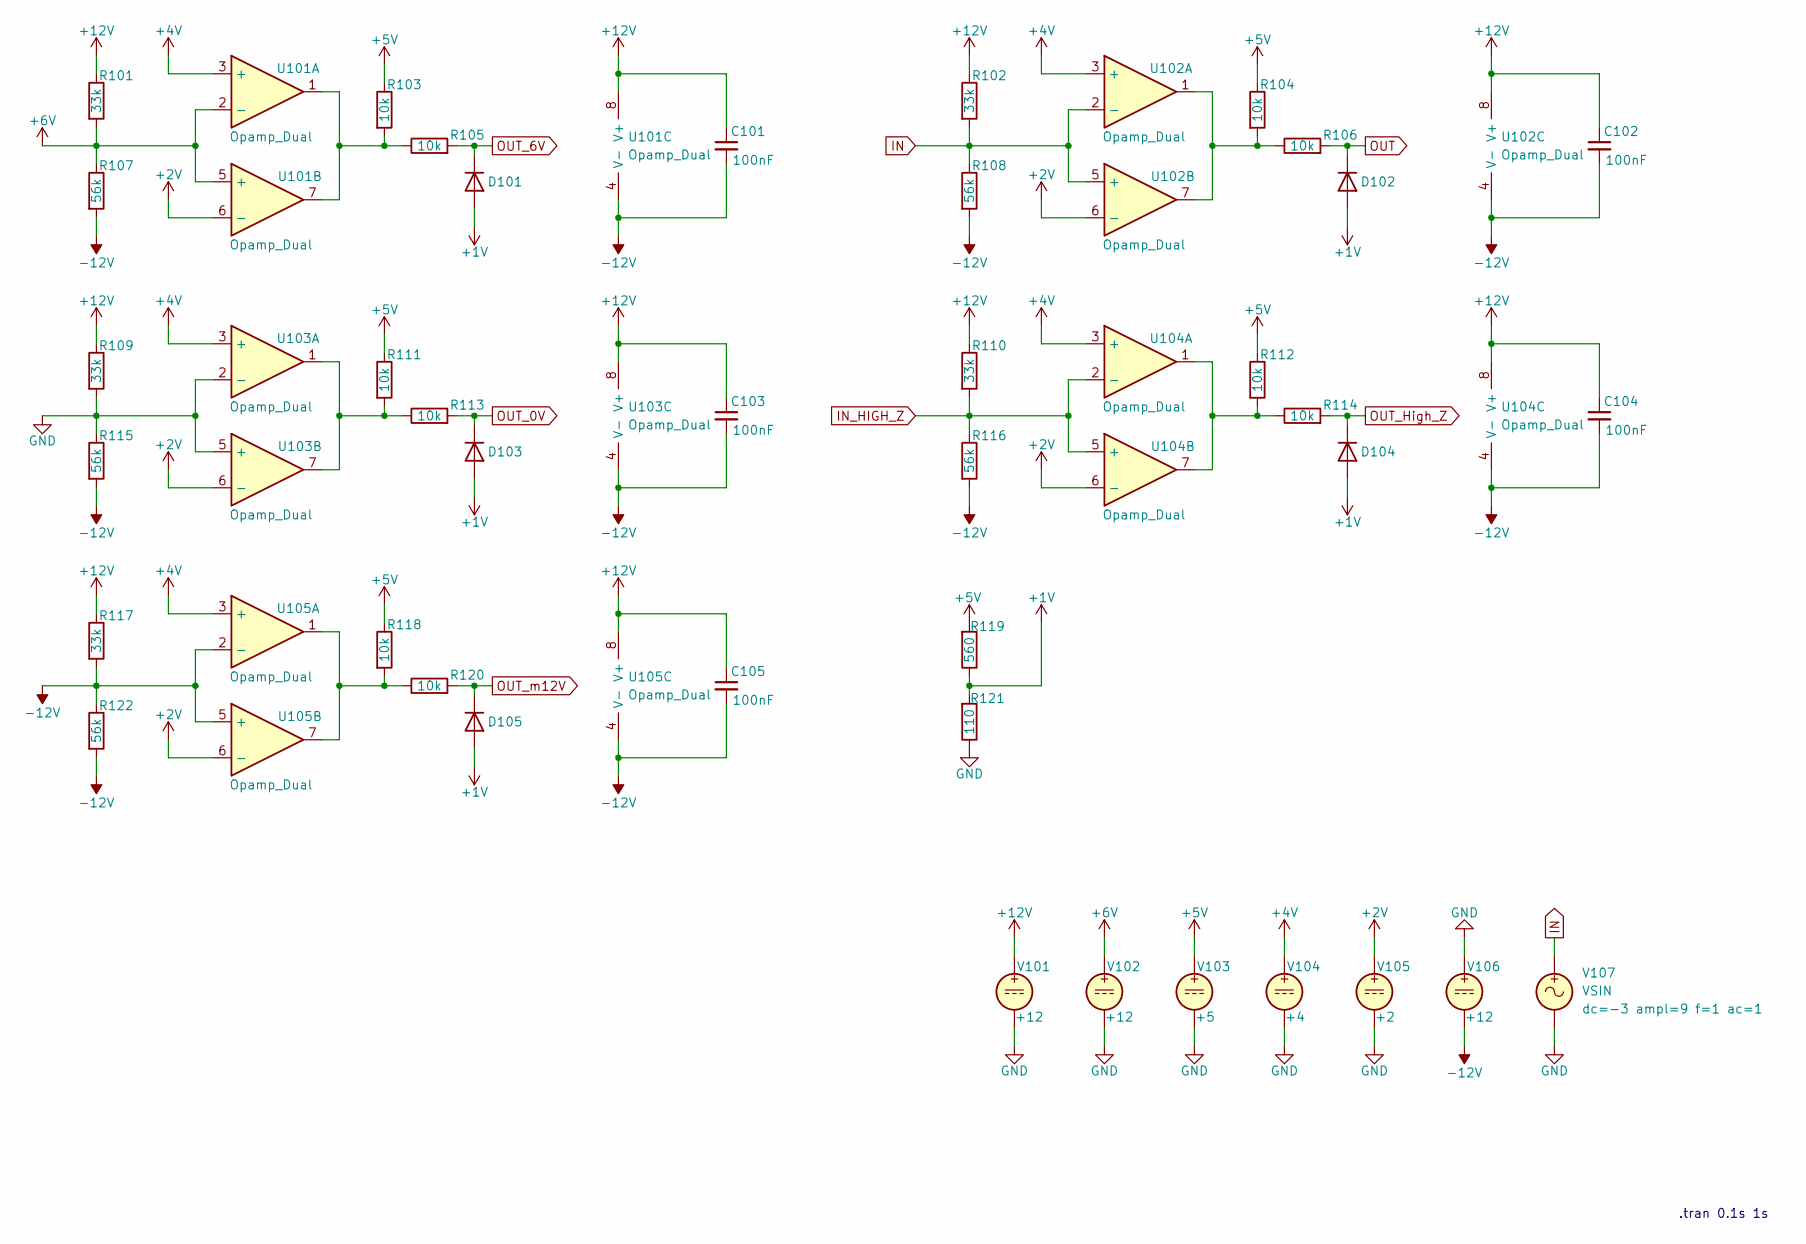
[picture p41: schematic Window_Comparator.kicad_sch]

Parts:
C101, C102, C103, C104, C105: 100nF; C_Disc_D5.0mm_W2.5mm_P5.00mm
D101, D102, D103, D104, D105: D
R101, R102, R109, R110, R117: 33k; R_Axial_DIN0207_L6.3mm_D2.5mm_P7.62mm_Horizontal
R103, R104, R105, R106, R111, R112, R113, R114, R118, R120: 10k; R_Axial_DIN0207_L6.3mm_D2.5mm_P7.62mm_Horizontal
R107, R108, R115, R116, R122: 56k; R_Axial_DIN0207_L6.3mm_D2.5mm_P7.62mm_Horizontal
R119: 560; R_Axial_DIN0207_L6.3mm_D2.5mm_P7.62mm_Horizontal
R121: 110; R_Axial_DIN0207_L6.3mm_D2.5mm_P7.62mm_Horizontal
U101, U102, U103, U104, U105: Opamp_Dual
V101, V102, V106: +12
V103: +5
V104: +4
V105: +2
V107: VSIN

Connections:
+1V: D101.2 (A), D102.2 (A), D103.2 (A), D104.2 (A), D105.2 (A), R119.1, R121.2
+2V: U101.6 (-), U102.6 (-), U103.6 (-), U104.6 (-), U105.6 (-), V105.1
+4V: U101.3 (+), U102.3 (+), U103.3 (+), U104.3 (+), U105.3 (+), V104.1
+5V: R103.1, R104.1, R111.1, R112.1, R118.1, R119.2, V103.1
+6V: R101.2, R107.1, U101.2 (-), U101.5 (+), V102.1
+12V: C101.1, C102.1, C103.1, C104.1, C105.1, R101.1, R102.1, R109.1, R110.1, R117.1, U101.8 (V+), U102.8 (V+), U103.8 (V+), U104.8 (V+), U105.8 (V+), V101.1
-12V: C101.2, C102.2, C103.2, C104.2, C105.2, R107.2, R108.2, R115.2, R116.2, R117.2, R122.1, R122.2, U101.4 (V-), U102.4 (V-), U103.4 (V-), U104.4 (V-), U105.2 (-), U105.4 (V-), U105.5 (+), V106.2
GND: R109.2, R115.1, R121.1, U103.2 (-), U103.5 (+), V101.2, V102.2, V103.2, V104.2, V105.2, V106.1, V107.2
IN: R102.2, R108.1, U102.2 (-), U102.5 (+), V107.1
IN_HIGH_Z: R110.2, R116.1, U104.2 (-), U104.5 (+)
unnamed: R103.2, R105.1, U101.1, U101.7
unnamed: R104.2, R106.1, U102.1, U102.7
unnamed: R111.2, R113.1, U103.1, U103.7
unnamed: R112.2, R114.1, U104.1, U104.7
unnamed: R118.2, R120.1, U105.1, U105.7
OUT: D102.1 (K), R106.2
OUT_0V: D103.1 (K), R113.2
OUT_6V: D101.1 (K), R105.2
OUT_High_Z: D104.1 (K), R114.2
OUT_m12V: D105.1 (K), R120.2

Notes on the sheet:
.tran 0.1s 1s
