Pynckels/versalogic_board_tester/software/design/src/main.c

/**
 * @file    main.c
 * @project VersaLogic Board Tester
 * @brief   Main program for Versalogic Board Tester (AVR)
 * @author  Filip Pynckels & Robin Pynckels
 * @version 1.0.alpha
 * @date    2025-08-13
 *
 * Description:
 *   This program controls the board tester hardware by interfacing with
 *   the shift buffers to maximize testing flexibility. Its logic includes:
 *     1. Reading floating pins (bits 4..40) to detect the inserted board type.
 *     2. Determining the board type using a "winner takes all" algorithm.
 *     3. Setting the direction of board pins according to the detected board.
 *     4. Looping through test scenarios: outputting TTL signals and verifying
 *        corresponding inputs.
 *
 *   UART communication is via TTL (5V/0V), and frequent reprogramming may
 *   require a ZIF socket.
 *
 * License:
 *   References the licenses used in:
 *   https://github.com/Pynckels/versalogic_board_tester
 *   Ensure compliance with the original license terms when redistributing or
 *   modifying.
 */

#include <avr/io.h>
#include <util/delay.h>


/**
 * @brief  Main entry point of the program.
 *
 * Initializes hardware peripherals and enters the main loop.
 * This loop can be extended to implement board detection, TTL testing,
 * and shift buffer control according to the detected board type.
 *
 * @param  none
 * @retval int  Standard return code (0)
 *
 * @note   Currently contains a placeholder delay. Replace with actual logic.
 */

int main(void) {
    // TODO: Initialize hardware peripherals here
    // e.g., shiftBufferInit(); uartInit(); pinSetup();

    while (1) {
        // TODO: Insert main board test loop here
        // Example: read floating pins, detect board type, run test scenarios

        _delay_ms(500);                                                         // Doing nothing… forever.
    }

    return 0;                                                                   // Dead code. If executed, please contact a priest
}
