Pynckels/versalogic_board_tester/(commit log)

2025-08-13 Consolidated upload
    [Back_To_Back_P-FET.kicad_sch, Board_Connector.kicad_sch, Controller.kicad_sch, Floating_Signal_Tester.kicad_sch, Power_Supply.kicad_sch, Setter_Getter.kicad_sch, Shift_In.kicad_sch, Shift_Out.kicad_sch]
2025-08-18 Editorial change
    [Controller.kicad_sch, Power_Supply.kicad_sch, Setter_Getter.kicad_sch, Shift_In.kicad_sch, Shift_Out.kicad_sch, Window_Comparator.kicad_sch]
2025-08-19 Quality assessment - Changes
    [Controller.kicad_sch, Window_Comparator.kicad_sch]
2025-08-23 Replaced solid state relay with electromechanical relay
    [Power_Supply.kicad_sch, Relay-Driver.kicad_sch, Setter_Getter.kicad_sch]
2025-08-23 Cleanup simulation directory
    [Back_To_Back_P-FET.kicad_sch]
2025-08-26 Simulating alternative power supply
    [Controller.kicad_sch, Power_Supply.kicad_sch, Relay-Driver.kicad_sch, Setter_Getter.kicad_sch, Window_Comparator.kicad_sch]
2025-08-28 Added proof of concept Window comparator
    [Window_Comparator.kicad_sch]
2025-08-30 Added Window comparator breadboard schematic
    [Window_Comparator.kicad_sch]
2025-08-31 Added Cascaded 74xx165 breadboard schematic
    [Cascaded_74xx165.kicad_sch]
2025-08-31 Editorial changes
    [Window_Comparator.kicad_sch]
2025-08-31 Added Cascaded 74xx595 breadboard schematic
    [Cascaded_74xx595.kicad_sch]
2025-09-05 Finished proof of concept Window_Comparator and integration test Window_Comparator with Cascaded_74xx165
    [Window_Comparator.kicad_sch]
2025-09-06 Finished proof of concept Relay_Driver
    [Relay_Driver.kicad_sch, Setter_Getter.kicad_sch, Window_Comparator.kicad_sch]
