Pynckels/versalogic_board_tester/(notices)

Notices in the files:
hardware/proofs_of_concept/Relay_Driver/Relay_Driver.kicad_sch:
Copyright (c) 2025 by Filip Pynckels & Robin Pynckels
